SangHyeon-Shin/SAVER/teensy/README_demo.md

# 수동 배치 시연 펌웨어 — 2026-10-23

마네킹·벤치 연구용. 임상 사용, 사람 대상 시험용이 아니다.
`saver_teensy.ino`가 진입점이며 구현은 `src/demo/`에 있다.
Arduino IDE에서는 **이 폴더의 `teensy.ino`를 연다. 폴더 전체를 유지한다.**
보드 Teensy 4.1, USB Type Serial, SparkFun MAX3010x 라이브러리가 필요하다.
`test_saver_proto.cpp`는 Arduino 빌드에서는 제외되고 PC 시험에서만 실행된다.

## 현재 가능한 것과 아직 안 되는 것

- `implemented`: VESC 전류 지령 기반 리니어 위치 PID, NAU7802 보정·힘 취득·힘 상한 정지,
  블로워 2개/압력 취득·간헐 제어, MAX30102 추정치 취득, JSON/직접 명령 공통 인터록,
  음압 확보 뒤 유한 압박을 시작하는 로컬 `BOTH` 통합 시험.
- `tested`: PC 모의 USB/UART/ADC/I²C 시험과 Teensy 컴파일. 실물 통합 시험 아님.
- `planned`/미검증: 실제 정지거리·보호 임계·블로워 운전 시간·전체 연결 동작.
  원점 리미트가 없으므로 **자동 HOME/탐색/압박점 접촉 탐색은 지원하지 않는다.**
- HOME은 `HOME_UNAVAILABLE_NO_VERIFIED_LIMIT`로 거부한다. 모터를 움직이지 않고
  HOMING_DONE/CP_ZERO_SET를 보내던 이전 자리표시자는 제거했다.
- **기존 Jetson UI의 S1→HOME→자동 탐색 전체 시나리오는 이 빌드로 통과하지 않는다.**
  수동 시연 UI/브리지 흐름은 해당 담당자와 별도 합의가 필요하다. `protocol/`, `jetson/`,
  `ui/`는 수정하지 않았다. 수동 시험 준비 뒤 START/PAUSE/RESUME/STOP JSON은 시험 가능하다.

## 먼저 확인 — 압박은 아직 기본 설정으로 구동되지 않는다

`src/demo/src/bench_config.h`의 미확인 보호 설정을 임의로 true/숫자로 채우지 않았다.
센서 읽기·보정·PPG는 가능하지만 `CP PREPARE`/`CP RUN`은 이 검증 전에는 거부한다.
`CP CHECK`에 실패 항목과 최종 구동 거부 이유가 나온다.

필요한 실측/확인:

1. VESC의 독립 명령 timeout 설정과 UART 분리 시 정지 확인.
2. 센서 배선/불량 입력 시험과 실물 조립 상태의 방향·보호 설정 검증.
3. 수동 영점 양쪽의 실제 소프트 경계와 정지 여유. 사용자 보고의 50 mm는 **기구 끝 근처의
   경계**이므로 TARGET 50 mm를 기본으로 넣지 않았다. 목표는 경계·보정 거리보다 작아야 한다.
4. 시작 위치/속도 허용치, 추종 오차, 센서 변화율·노이즈, 프로파일 속도/가속도 한계.
5. 위 검증 뒤 마지막으로 `BENCH_DRIVE_CONFIRMED`. 단순히 구동하려고 일괄 true로 바꾸면 안 된다.

LM 소스의 기본값은 ILIMIT 6 A, INLIMIT 2.8 A였다. 이 값은 실측으로 결정한 새 권장값이 아니다.
메인의 깊이/분당 횟수는 0/미설정으로 시작하며 TARGET을 보내기 전에는 압박하지 않는다.
메인은 PROJECT_STATE의 초회 6 A/정상 감시 12 A와 맞춰, 전류 명령 상한을 초회 6 A로 유지했다.
입력 전류, 모터 전류는 서로 다른 값이다. PSU의 10 A 정격을 모터 전류 한계로 취급하지 않는다.
상단/하단 스위치와 E-stop 보조접점은 사용자 설명대로 미장착이다. 없는데 정상이라고 보고하지 않는다.
이 스위치 생략은 **사람 없는 수동 벤치 치구 범위**에만 해당한다.

## 직접 명령: 시리얼 모니터, 115200, Newline 또는 CRLF

모든 출력은 LF로 끝나는 JSON이다. 직접 명령 결과는 BENCH_LOG의 msg 안에 표시된다.
보정값/동작은 장치가 자동 추정해서 채우지 않는다. `<...>`는 확정한 값을 넣을 자리이며 그대로 입력하지 않는다.

### 1. 센서부터

```text
STREAM OFF
HELP
STATUS
PPG ON
```

`STATUS`에서 힘/압력/PPG/현재 위치의 진단을 볼 수 있다. 주기 요약은 기본 20 Hz이다.
직접 시험에서 스크롤이 빠르면 STREAM OFF로 주기 출력만 끄고 STATUS로 확인한다.
센서/제어/인터록은 계속 작동한다. STREAM ON으로 다시 켜며 REMOTE 전환 시 출력도 복구한다.
손가락 접촉·신호 품질이 확보되기 전 HR/SpO2는 생략하며 임의 숫자로 대체하지 않는다.
SpO2/심박 추정의 임상 정확도를 검증한 것은 아니다. 종료는 `PPG OFF`.

### 2. 압박부 보정·준비

기존 안전한 보정 방법으로 기준 위치와 실제 이동 거리를 잡는다. 보정 명령 자체는 모터를 돌리지 않는다.

```text
CP ZERO
CP CAL <실제로_이동한_양의_거리_mm>
```

CAL 뒤 기준 위치로 복귀하고 멈춘 뒤 진행한다. ZERO는 새 RAM 보정을 시작하고 CAL을 무효화한다.
기존 리니어 EEPROM 보정은 부팅 때 읽으며, 위 명령으로 EEPROM 원본을 덮어쓰지 않는다.
센서/기구 설치가 바뀌면 보존된 값이 있어도 영점·방향·실측 거리를 다시 확인한다.

```text
CP TARE
CP FORCE_CAL <실제로_올린_기준_질량_kg>
```

TARE 완료 로그를 기다린 뒤 기준 질량을 가하고 FORCE_CAL을 보낸다. 완료를 기다리고 질량을 제거한다.
질량은 0 초과 100 kg 이하이며 센서·치구 허용 하중을 넘기지 않는다. 평균 320개의 신규 샘플을 사용한다.
두 측정 구간이 겹치거나 레일/시간 초과면 보정을 인정하지 않는다. 힘은 N으로 환산한다.
보정은 RAM에 있어 재부팅하면 다시 필요하다. USB 단순 재연결은 완료된 센서 보정을 지우지 않는다.
NAU7802 오류 후 재시험은 `CP SENSOR_RETRY` → TARE → FORCE_CAL. 자동 재시작은 없다.

```text
CP TARGET <시험_깊이_mm> <분당_완전_왕복_횟수>
CP FORCELIMIT <확정한_벤치_힘_상한_N>
CP ILIMIT <검토한_모터_명령_전류_상한_A>
CP INLIMIT <검토한_입력_전류_정지_기준_A>
CP CHECK
```

힘 상한은 처음에는 0/미설정이며, 설정 전에는 압박을 거부한다. 입력 허용 상한 600 N은 D-30의
벤치 시험 상한이지 임상 상한이나 모든 치구에 안전한 값이 아니다. 더 낮은 치구 한계를 우선한다.
CHECK가 실제 검증 설정/실시간 상태를 모두 통과했을 때만:

```text
CP PREPARE
CP RUN 3
STOP
```

RUN 3은 3회 완전 왕복이다. RUN만 보내면 1회. 모든 RUN은 사용자 요청의 최대 10분 제한을 받는다.
시작/종료의 위치 오차, 추종·힘·전류·센서·VESC·시간 이상은 정지한다. 기구 끝을 원점/목표로 쓰지 않는다.
PREPARE는 **수동 벤치 기준 확인**이지 자동 HOME/접촉 탐색 완료가 아니다. 설정 변경·STOP 후 다시 필요하다.
`STOP`은 압박 정지 요청이며 **흡착은 유지한다**. VESC 전류 0은 능동 제동/위치 유지 보증이 아니다.
고장은 원인을 제거하고 `CP CLEAR`; 자동으로 RUN을 다시 보내지 않는다.

### 3. 음압부

센서 분압은 사용자가 실제로 설치한 위 4.7 kΩ/아래 10 kΩ 기준이다. 공급전압 이상을 영점 보정으로 숨기지 않는다.
센서 OUT 5 V까지 입력될 경우 이 분압만으로 ADC 3.3 V 초과를 막지 못하므로 전기적 보호를 따로 확인한다.

```text
VAC CONFIG <듀티_pct> <최대_연속_ON_ms> <도달_안정_ms> <해제_압력대역_kPa_양수> <해제_안정_ms>
VAC ARM
VAC RUNBOTH <모터1_pct> <모터2_pct>
VAC OFF
```

운전/해제 시간·대역은 미확정이므로 기본 0이다. 팀이 확인한 값을 넣기 전에는 구동/자동 해제 판정을 막는다.
RUN1/RUN2도 가능하며 수동 듀티 시험도 최대 연속 ON 시간을 적용한다. 시간 만료/압력 무효/ERR는 정지한다.
`VAC CLEAR_ERR`는 원인이 없어지고 ERR가 안정적으로 정상인 뒤에만 해제한다. 고장/시간 제한을 우회하지 않는다.

`VAC ON`은 D-27 정책의 자동 간헐 제어다: 목표 −22.5 kPa에서 정지, −20 kPa보다 약해지면 재기동.
설정한 연속 ON 상한에 도달하면 −20 kPa 이하인 경우 도달 압력을 정지 기준으로 삼고, 미달이면 정지·고장 처리한다.
실제 흡착 도달 판정을 기다린 후에 압박을 준비한다. 체크밸브/블로워 온도·저유량 허용시간은 미검증이다.
`VAC OFF`는 출력 OFF일 뿐 즉시 흡착 해제 보증이 아니다. 압력 대역/시간을 만족해야 mot.vac_released가 true다.
압박 중 VAC 설정/해제를 거부하므로 먼저 STOP한다.

### 4. 음압 + 압박 통합 시험 (`BOTH`, 직접 벤치 명령만)

`implemented`, PC 모의 `tested`; 실물 통합 구동은 미검증이다. Jetson JSON 명령/상태머신은
추가하거나 바꾸지 않았다. `BOTH`는 별도 운용 상태가 아니라 기존 제어기를 순서대로 요청하는
벤치 보조 기능이다. PPG를 자동으로 켜지 않는다.

사용자가 설명한 공급 전류 배분은 **블로워 각각 3 A + VESC 입력 3 A**다. 총 9 A이며,
10 A 전원의 계산상 잔여는 1 A다. 이는 모터 정격이나 총전류 실측/제어를 뜻하지 않는다.
블로워 듀티 약 22에서 각각 약 3 A, VESC 모터 전류 지령 10 A에서 공급 전류 약 0.6 A를
봤다는 사용자 관찰이 있다. **기동·부하 변화 때 최대값, 동시 시험 결과는 아직 미검증**이다.
VESC 모터 측 전류와 입력 전류를 혼동하지 않으며, 이 관찰만으로 메인의 초회 모터 지령
상한 6 A를 10 A로 올리지 않았다. 입력 3 A는 수신값 기반 정지 기준이지 순간 하드웨어 제한이 아니다.

먼저 앞 절의 리니어/로드셀 보정·목표·힘 상한과 구동 보호 검증을 끝내고, 압박 정지/음압 OFF,
압력관 대기 개방 상태에서 시작한다. **대기 개방 −24.60 kPa 오류를 먼저 해결한다.**
설정한 해제 압력대역/시간을 만족해야 시작할 수 있다. 이것은 잘못된 영점으로 흡착 완료를
판정하지 않기 위한 검사이며, 센서 정확도 교정을 대신하지 않는다.

```text
VAC CONFIG 22 <최대_연속_ON_ms> <도달_안정_ms> <해제_압력대역_kPa> <해제_안정_ms>
CP INLIMIT 3
BOTH POWER <블로워1_최대_공급_A> <블로워2_최대_공급_A> <같은_전원의_기타_최대_부하_A>
CP PREPARE
BOTH CHECK
BOTH RUN 3
```

- 듀티 22는 사용자 관찰값일 뿐 **3 A 정전류 설정이 아니다**. 사용할 듀티에서 기동 포함
  전류를 재고 `BOTH POWER`에 상한을 기록한다. 각 블로워 상한은 3 A 이하, 기타 부하 포함
  합계 + 압박 입력 배정 3 A는 10 A **미만**이어야 한다. `other=0`은 같은 전원에 기타 부하가
  실제로 없을 때만 쓴다. 총전류 센서는 현재 사용하지 않으므로 이 입력값을 자동 검증할 수 없다.
  `BOTH POWER 3 3 0`은 이 조건을 실측 확인했을 때만 사용할 수 있는 예다.
- `CP INLIMIT`은 3 A 이하를 허용한다(기본 2.8 A도 이하). `CP ILIMIT`은 **모터 측 지령 한계**로
  별개이며 기존 설정/보호를 유지한다. 강제로 정확히 3 A를 소비하게 하는 기능은 없다.
- POWER는 준비 허가를 취소하므로 **그 뒤 CP PREPARE**한다. VAC 설정/듀티/ARM/ON 변경이나
  USB 재연결 뒤에는 POWER를 다시 기록한다. 기존 보정값을 새로 만들거나 지우지는 않는다.
- `BOTH CHECK`는 준비 안 된 첫 이유를, `BOTH STATUS`는 대기/구동/공급 예산을 보여 준다.
  CHECK가 통과해도 실물 안전 검증을 보증하지 않는다. 기본 구동 잠금은 그대로다.
- RUN은 먼저 블로워 2개를 자동 제어하고, 유효한 압력으로 안정된 흡착이 확인돼야 압박을 시작한다.
  압박 시작 직전에도 같은 인터록을 다시 검사한다. 리니어/로드셀/압력을 계속 읽는다.
  위 예는 **이미 설정한 깊이·분당 횟수로 3회 왕복**이다. RUN 인수는 듀티나 전류가 아니다.
- 흡착 대기는 CONFIG의 최대 연속 ON 시간과 같은 길이를 **총 대기 상한**으로도 적용한다.
  그 안에 안정 도달하지 못하면 블로워 출력을 끄고 압박을 시작하지 않는다. 압박 시작 후에는
  흡착 유지 제어를 병행한다. 요청부터 총 10분 상한 또는 요청 횟수 완료 시 압박을 멈춘다.
  압박 종료/일반 고장 시에는 흡착을 자동 해제하지 않는다.
- `STOP` / `BOTH STOP`은 압박을 멈추고 대기 중 자동 시작도 취소하며 **음압은 유지**한다.
  실제 기구 정지를 확인하고 필요할 때 `VAC OFF`로 별도 해제한다. USB 단절·손상 명령·센서 고장도
  미완료 요청을 취소한다. 재연결/오류 해제 뒤 자동 재시작하지 않는다.
- 음압 단독의 5 A × 2 계획은 전원 10 A 전부이므로 기동/기타 부하 여유가 없다. 듀티를 전류로
  바꾸거나 자동으로 상향하지 않았다. PSU CC 설정, 기동 전압 강하·총전류·VESC 회생은 실측한다.

## Jetson JSON 제어와 직접 제어의 구분

- 기본 v1.1: GET_INFO/GET_STATUS/PING/GET_FAULTS는 seq만 필요하다.
- 그 밖에는 INFO의 boot_id를 bid로, 증가하는 aid를 넣는다. wire 필드 v는 여전히 1이다.
- 동일 요청 재전송은 최초 ACK를 재전송하고 동작을 반복하지 않는다. 거부 ACK도 그대로 보존한다.
- STOP_CPR/PAUSE_CPR/DISARM/DRIVE_STOP은 완전한 JSON 구조·정확한 명령명을 확인한 뒤,
  bid/aid/버전 검사에 앞서 해당 정지 출력을 적용한다. VACUUM_OFF는 이 예외가 아니다.
- INFO에는 실제 구현한 AID/MOT만 광고한다. DRIVE/HEAD_HOLD/CP_ZERO는 광고하지 않는다.
  미합의 고장 코드를 지어내거나 기존 코드 의미를 바꾸지 않는다. 대응 코드가 없는 벤치 고장은
  FAULT 상태와 BENCH_LOG 사유로 보고하고, faults를 빈 배열로 꾸미지 않고 생략한다.
  GET_FAULTS는 합의된 코드의 err와 FAULTS_END를 반환하나 미할당 벤치 고장이 있어 FAULTS capability는 광고하지 않는다.
  원인 제거 후 `CLEAR_FAULT` 또는 원격 `RESET_FAULT`로 해제를 요청한다. 구동은 다시 준비해야 한다.
- 직접 시험이 제어권을 갖고 있으면 JSON 구동 요청을 거부한다. 조회·정지는 항상 처리한다.
- 원격 ARM은 PPG 관측도 시작한다. 직접 시험은 `PPG ON`으로 별도 시작한다. 센서 취득만으로 압박을 시작하지 않는다.

직접 보정/목표 설정/CP PREPARE를 마치고 압박이 정지한 상태에서:

```text
CONTROL REMOTE
```

그 후 Jetson 시험 클라이언트가 GET_INFO로 세션을 확인하고 START_CPR을 보낼 수 있다.
시리얼 모니터와 Jetson 브리지가 같은 포트를 동시에 열면 안 된다. 열고 닫으면 준비/제어권은 취소되므로,
Jetson 시험 클라이언트가 연결된 같은 세션에서 명시적인 벤치 준비를 해야 한다. 기존 UI에 이를 몰래 추가하지 않았다.
원점 리미트 없는 전체 UI 초기화 문제를 성공 이벤트로 숨기지 않는다.

```json
{"v":1,"t":"cmd","seq":1,"cmd":"GET_INFO"}
{"v":1,"t":"cmd","seq":2,"cmd":"GET_STATUS"}
{"v":1,"t":"cmd","seq":3,"cmd":"PING"}
{"v":1,"t":"cmd","seq":4,"cmd":"PAUSE_CPR"}
{"v":1,"t":"cmd","seq":5,"cmd":"STOP_CPR","reason":"USER_STOP"}
```

START_CPR/RESUME_CPR는 모든 인터록을 다시 검사한다. RESUME는 CPR_PAUSED에서만 받는다.
임의의 중간 위치에서 재개하지 않으며, 기존 리니어 제어의 시작 원점/안정 조건을 다시 만족해야 한다.
PAUSE ACK는 수락만 뜻한다. 전류 0 송신이 끝나고 신규 VESC 정지값과 리니어 속도가 안정된 뒤 CPR_PAUSED가 된다.
STOP/FAULT 상태나 ACK만으로 실제 완전 정지가 확인됐다는 음성을 내면 안 된다.
원격 제어에서는 유효 JSON이 2초 동안 없으면 압박을 즉시 정지하고 음압은 유지한다.
미확정 T_comm의 30초 지속은 하지 않는다. 신규 START/RESUME는 최대 10분의 유한 시험이다.

작업 트리의 구형 v1.0 Jetson을 사용할 때만 정지 중 명시적으로 `CONTROL REMOTE_V1`을 선택한다.
seq만 있는 구형 요청을 받고 최근 8건의 ACK를 저장한다. INFO도 proto 1.0/caps 빈 배열로 응답한다.
**aid가 없다는 이유로 자동 강등하지 않는다.** v1.1 연결은 `CONTROL REMOTE`를 사용한다.
구형 형식에는 bid/aid를 통한 과거 세션 배제가 없다. 연결이 끊기면 과거 동작 요청을 재송신하지 않는다.

## 전원/정지의 제약

USB 재연결은 RAM 초기화가 아니지만 압박 구동 허가/미완료 명령/준비 상태는 취소한다.
리니어 저장 레코드 4096..4135를 보존하고 별도 4160..4175에 이중 기록으로 boot_id를 쓴다.
재부팅/전원 차단은 RAM 하중 보정/설정/준비를 지운다. boot_id 기록에 실패하면 ARM/구동을 허용하지 않는다.
일반 DISARM/압박 FAULT/통신 단절은 흡착을 임의로 해제하지 않는다. 압력 센서/블로워 자체가 고장 나면
음압 출력을 정지하고 압박도 멈춘다. 물리 E-stop의 전력 차단 범위를 소프트웨어로 보증하지 않는다.

**Teensy를 Jetson USB로만 급전하면 USB 전원 차단 때 프로그램도 멈춘다.** 그 뒤 STOP을 보낼 수 없다.
독립 VESC timeout, 블로워 EN/VSP 외부 풀다운, 물리 전원 차단이 필요하다.
Teensy의 USB/3.3 V에서 모터를 급전하지 않는다. 모터 측 +5 V 출력도 연결하지 않는다.
센서 소비 전류/Jetson 전원 여유, 역급전, 실제 정지는 별도 실측한다.

## 검증 명령

```powershell
powershell -NoProfile -ExecutionPolicy Bypass -File teensy/tests/demo/check_main.ps1
powershell -NoProfile -ExecutionPolicy Bypass -File teensy/tests/check_pinmap.ps1
arduino-cli compile --fqbn teensy:avr:teensy41 --warnings all --build-path <임시_빌드_경로> teensy
```

PC 표준 시험: `g++ -std=c++11 -Wall -o <임시_실행파일> teensy/test_saver_proto.cpp` 뒤 실행한다.
새 합성 fixture는 PC 시험 전용이며 Arduino가 읽지 않는다. 실기 업로드/통전 시험은 자동 실행하지 않는다.

### 이번 작업의 검증 기록

- `tested`(PC 모의): 기본 설정 207개 + 합성 치구 317개, 합계 524개 통과.
  구동 잠금, 실제 메인 명령 경로, 부호/전류 한계, 중복·거부 ACK, 잘린 줄, USB 재연결,
  압력/힘/센서/VESC/UART 고장, 간헐 음압·시간 상한, 부팅 기록 실패 우회 방지를 검사했다.
  통합 시험의 음압 안정 선행/왕복 횟수/입력 전류 3 A 초과 정지/유한 종료/총 시간 상한,
  대기 중 취소·USB·VESC·로드셀·압력 고장, 전류 예산과 듀티 변경 시 재확인도 검사했다.
- `tested`(PC 모의): 출력 JSON 1190줄의 구문/길이와 tel/mot의 tn·ms·boot_id 짝을 검사했다.
- `tested`(PC): 기존 test_saver_proto.cpp 26/26, 핀맵 컴파일 시 단언 19개와 소스 가드 통과.
- `tested`(빌드): 실제 teensy 폴더를 Teensy 4.1로 컴파일 성공. 프로젝트 코드 경고 없음;
  SparkFun 외부 라이브러리의 기존 경고 4개는 남아 있다.
- 포맷, git diff 공백 검사, tools/consistency_audit.py 통과. protocol/jetson/ui 변경 없음.
- 하드웨어 `planned`/미검증: 업로드, 실전압/실전류, 실제 이동·정지거리, 실물 안전 인터록,
  열/장시간 운전, USB 전원 상실과 역급전, 전체 UI 연결. 위 PC 결과로 이를 통과했다고 주장하지 않는다.
