SangHyeon-Shin/SAVER/docs/DECISIONS.md

# 기술 결정 기록

**"왜 이렇게 되어 있는가"에 대한 답입니다.**
같은 논의를 반복하지 않기 위해, 그리고 최종보고서를 쓸 때 근거를 다시 찾지 않기 위해
남깁니다. 결정을 뒤집을 때는 이 문서를 먼저 고치세요.

---

## 아키텍처

### D-01 · 상태머신의 주인은 Jetson 브리지다

**결정**: 운용 상태머신(S1~S13)은 Python 브리지가 소유한다.
UI 는 `intent` 를 보내고 받은 `state` 를 그리기만 한다.

**이유**: 레이더·카메라·PPG 판단 입력이 전부 Python 에 도착하는데,
상태의 주인이 브라우저에 있으면 판단과 화면이 어긋난다.
UI 를 새로고침해도 장치 상태가 바뀌면 안 된다는 요구사항과도 맞는다.

**예외**: 브리지 미연결 시 UI 가 로컬 전이로 대체한다. **오프라인 시연 전용**이며,
연결되면 즉시 브리지 판단으로 넘어간다.

### D-02 · 상태머신 정의는 파일 하나뿐이다

**결정**: `protocol/state_machine_v2.json` 이 유일한 기준.
Python 은 직접 읽고, UI 는 빌드 전에 자동 복사(`ui/scripts/sync-protocol.mjs`)한다.

**이유**: 처음에는 UI 와 Python 이 각자 전이표를 갖고 있었다.
한쪽만 고치면 조용히 어긋나고, 통합 시점에야 발견된다.

### D-03 · Jetson 은 실시간 제어를 하지 않는다

**결정**: 100~500 Hz 제어 루프는 Teensy 전담. Jetson 은 목표값만 보낸다.

**이유**: Linux 스케줄링, USB 지연, Python GC, UI 부하 때문에 제어 주기가 흔들린다.
`S2_데이터_수집처리_정의서` 에 기구 제어 데이터가 100~500 Hz 로 정의돼 있다.

**금지되는 구조**
```
Jetson 이 깊이를 읽음 → Python 에서 PID 계산 → 매 주기 Teensy 에 PWM 명령
```

### D-04 · 장치가 준비되지 않으면 화면이 넘어가지 않는다

**결정**: `state_machine_v2.json` 의 `requires_mcu` 로 전이 선행조건을 검사한다.

**이유**: 종단간 시험에서 실제로 발생했다. 흡착이 끝나기 전에 사용자가
[재확인]을 연타하니 UI 만 앞서 나갔다. 레이더·카메라가 붙으면 더 심해진다.

거부되면 UI 에 `{"reason":"device_not_ready","mcu":"HOMED"}` 가 전달되고
"장치 준비 중" 안내가 뜬다.

### D-05 · 압박점 확정은 장치가 주도한다

**결정**: `SCAN_RESULT` 를 받는 즉시 브리지가 `SET_CP_POINT` 를 보낸다.
사용자의 [확인] 버튼과 무관하다.

**이유**: 사용자가 버튼을 늦게 누르면 장치가 `CPR_READY` 에 못 올라가
다음 상태 진입이 막힌다. 화면 진행과 장치 준비를 분리해야 한다.

### D-06 · 통신은 JSON Lines, 라이브러리는 쓰지 않는다

**결정**: 한 줄에 JSON 하나. Teensy 측은 `saver_proto.h` 자체 파서.

**이유**: 시리얼 모니터로 눈으로 읽으며 디버깅할 수 있다.
프로토콜이 1단계 평면 구조라 ArduinoJson 이 필요 없고, 라이브러리 버전 문제도 없다.
PC 에서 `g++` 로 단위시험도 된다.
데이터량이 실제로 문제가 되면 그때 COBS/CBOR/바이너리로 바꾼다.

### D-07 · 측정 불가 필드는 0 이 아니라 생략한다

**결정**: 값이 없으면 필드를 통째로 뺀다.

**이유**: `0` 을 보내면 Jetson 이 "정상적으로 0" 으로 오해한다.
PPG 신호 품질이 나쁠 때 심박 0 과 미측정은 완전히 다른 의미다.

### D-08 · 심각도 3 오류는 정지가 먼저, 보고가 나중

**결정**: Teensy 는 모터를 끈 뒤에 `err` 메시지를 보낸다.

**이유**: 보고를 먼저 하면 그 사이 시리얼이 막혔을 때 모터가 계속 돈다.

### D-09 · 소프트웨어 정지는 물리 E-stop 을 대체하지 않는다

**결정**: E-stop 은 USB 와 무관한 하드웨어 회로가 모터 출력을 끊는다.
Teensy 는 그 사실을 보고만 한다.

**이유**: Jetson 이 죽어도, 시리얼이 끊겨도, 펌웨어가 멈춰도 정지해야 한다.

### D-10 · 제어 보드는 Teensy 4.1 (2026-08-03)

**결정**: Teensy 4.1. PCB 미발주.

**이유**: 이력의 회로도·펌웨어는 ESP32-S3 기준이었으나 발주 전이라 변경 비용이 없다.
Teensy 4.1 은 하드웨어 FPU 가 있어 제어 루프에 유리하고, 네이티브 USB 라
UART 브리지 지연이 없다.

**영향**: 핀 전면 재배정, `analogReadResolution(12)` 필요, PCB 재작성.
자세한 내용은 `teensy/reference/README.md` §2.

---

## 기구·전기

### D-20 · 감속비 1.5 (2.0 아님)

**결정**: 타이밍 벨트 1.5:1.

**이유**: 2.0 이면 필요 회전수가 저전압 구간에서 부족했다.
1.5 로 낮추면 2,592 RPM 이면 되고 RPM 부족이 해소된다.
모터는 BL60120-2430 (Ke = 4.45 V/kRPM).

### D-21 · 볼스크류 후보는 1사이클 전체 프로파일로 검증한다

**결정**: 피크값 합산 방식은 쓰지 않는다.

**이유**: 피크 합산은 힘을 약 2.5배 과대평가한다. 후보가 잘못 탈락한다.

### D-22 · PETG-HF 는 준취성으로 다룬다

**결정**: FEA 에서 인장강도 하한값을 항복강도 대용으로 쓰고 안전계수를 추가한다.

**이유**: 명확한 항복점이 없다. **Z 방향 강도가 32% 감소**하므로
반복 하중을 받는 부품은 적층 방향을 반드시 고려해야 한다.

### D-23 · 설계 목표 음압은 −22.5 kPa 이며 −30 kPa 는 도달 불가 (2026-09-08 근거 보강)

**결정**: 목표 −22.5 ±2.5 kPa (펌웨어, 2026-08-03 확정). 검증 합격선은 허용 하한 −20 kPa.

**이유**: 음압 블로워 BL6561-P(24 V) 팬 커브의 dead-head 정압이 약 27.3 kPa 라
−30 kPa 는 이 블로워로 물리적으로 도달할 수 없다. CFD 누설 해석
(`SAVER-docs/cfd/SAVER_CFD_results_final.csv`)에서 바닥 슬릿 갭 0.05~0.30 mm 의
운전점은 −27.0~−17.8 kPa 이고, −22.5 kPa 는 갭 약 0.19 mm 까지, 허용대역
−20~−25 kPa 는 갭 약 0.12~0.25 mm 에 해당한다. 초기 문서(중간보고서, ESP32 코드)의
−30 kPa 는 블로워 선정 전 목표였다.

### D-24 · "유지력 상한 290 N" 폐기 → 명목 유지력 3600 N (−20 kPa) (2026-09-08)

**결정**: 유지력은 F = ΔP·A_eff 로 표기한다. 1:1 명목 면적 0.18 m² 기준 −20 kPa 에서
3600 N, −22.5 kPa 에서 4050 N. A_eff 는 1:1 CAD 챔버 내측 치수로 확정한다(서정준).

**이유**: 290 N 은 dead-head 27.3 kPa 에 CFD 모델의 패드 면적을 곱한 값이다. CFD 그림
스크립트의 면적 상수(π·0.058² ≈ 106 cm², 반지름 58 mm 축대칭 원형 모델)로 2026-09-10 확인.
1:2 축척 추정이라는 초기 기록은 잘못이었다. 이 면적은 실제 300×300 mm 패드가 아니므로
유지력 상한으로 쓰지 않는다. 단, 같은 이유로 CFD 운전점(Table 6)도 모델 형상 기준이며
실제 패드(누설 둘레 6.6배)에서는 더 낮을 수 있다 → 재해석 항목.

**영향**: requirements R2, evidence C3, `report/02_design.qmd`, `tools/consistency_audit.py`
CHECKS 갱신. 보고서에는 명목 유지력을 `simulated` 로, 실측은 T1 이후 `tested` 로.

### D-25 · 시제품 축척은 1:1 (2026-09-08)

**결정**: 1:2 축척을 폐기하고 1:1 로 출력한다.

**이유**: 길이를 1/2 로 줄이면 면적·하중이 1/4 이 되어 T1 결과를 실기 값으로 환산할 수
없다. 보고서 v9 2.4.1·2.8.1 의 축척 서술은 삭제한다. FEA 모델 축척도 1:1 인지 확인한다.

### D-26 · 요구 최소 음압 산정 기준 (2026-09-08)

**결정**: 요구 최소 음압 = 최대 압박력 555.1 N × 안전율 2 / 명목 면적 0.18 m² ≈ −6.2 kPa.

**이유**: 이전 −5.6 kPa 는 500 N 기준이었고, 확정 최대 압박력 555.1 N 과 정합시킨다.
설계 목표 −22.5 kPa 는 요구의 약 3.6배로, 누설·표면 상태 여유다.

### D-27 · 블로워 최소 연속 운전 유량과 간헐 운전 (확인 조건부, 2026-09-08)

**결정(안)**: BL6561-P 의 최소 연속 운전 유량 400 L/min(제조사 자료 확인 전, 가정)을
밑도는 운전점에서는 연속 dead-head 운전을 하지 않는다. 블로워는 p_g 가 목표 −22.5 kPa
에 이르면 정지하고 허용 하한 −20 kPa 보다 약해지면 재기동한다. 목표에 도달하지 못하는
조건(예: 24 V·갭 0.20 mm 의 −21.8 kPa, 공칭 22.2 V)에서는 정지 조건이 성립하지 않으므로
도달 시간 상한(설정값) 안에 목표 미달이면 (a) p_g ≤ −20 kPa 이면 도달 압력을 유지 기준으로
삼아 대역을 [도달 압력, −20 kPa] 로 두고 (b) −20 kPa 미달이면 2-VU-004 로 보고·정지한다
(2026-09-10 보완). T1 은 정전압 24 V 조건으로 한정한다.

**이유**: 최소 연속 유량 400 L/min 과 dead-head(유량 0)는 동시에 성립할 수 없다.
400 L/min 에서 팬 커브 정압은 약 19 kPa 로 목표 −22.5 kPa 에 못 미친다.

**확인**: 데이터시트 원문(한건민), 제어 구현(한건민). 확인 전에는 `assumed`.

### D-28 · 시험 합격 기준의 출처 (2026-09-08)

T1 은 −20 kPa (허용 하한) 도달·유지. T2 는 깊이 ±5 mm, 속도 100~120 회/min
(W11 마네킹 시험 프로토콜·지침). 설계 목표(±2 mm, 110 ±2 회/min)는 합격 기준과
분리해 표기한다. 음압 도달 시간은 합격 기준이 아니며 실측 후 결정한다.

### D-29 · 압박 운동 프로파일: 사인파를 설계 기준으로, 삼각파는 제어 해석·힘 상한 산정에 (2026-09-08)

**결정**: 구동계 선정과 회전수 여유 검토는 사인파 궤적(스트로크 50 mm, 110 회/min → 최대 속도
0.288 m/s, 2,592 rpm)을 기준으로 한다. Simulink 제어 해석은 삼각파 목표(0.183 m/s, 1,650 rpm)로
수행하며, 최대 압박력 555.1 N 은 삼각파에서 강성항·점성항 최대값을 더한 보수적 상한이다
(사인파 위상 고려 시 약 515 N).

**이유**: v10 은 2.6.1(삼각파 속도), 2.6.2(사인파 회전수), 2.6.3(삼각파 목표)을 같은 조건처럼
연결하고 있었다. v4.2 종합해석도 사인파 궤적이므로 선정 기준을 사인파로 통일하고, 다른
프로파일의 값은 그 조건을 명시해 병기한다. 펌웨어가 실제로 지령할 프로파일은 구현 시 확정.

### D-30 · 벤치 시험 설정값은 임상 적용값과 분리한다 (2026-09-08)

**결정**: 벤치 시험 설정 깊이 50 mm(지침 약 5 cm, 마네킹 시험 프로토콜 50~60 mm 범위 내),
시험 힘 상한 600 N(구조 설계 하중). 시험체·구동부의 허용 범위에서 추종·제한 동작을 평가하기
위한 값이며, 환자에게 적절한 깊이·힘을 확정한 것이 아니다. 임상 적용값(`target_depth_mm`,
`force_max_N`)은 여전히 한성윤 확인 대상이다.

**이유**: 모든 시험 설정을 의학 검토 대기로 두면 핵심 공학 시험(T2)까지 지연된다.

---

### D-32 · 자이로 UART 확보와 로드셀 독립 I²C (2026-10-02)

**결정**: 사용자 선택으로 NAU7802를 Wire1(SDA 17 / SCL 16)에 분리하고,
주행 모터 1 엔코더 A/B를 11/12로 옮긴다. MAX30102는 Wire(18/19)를 유지한다.
WT901C-TTL은 Serial8(RX 34 / TX 35)에 예약하며 음압 모터 2 RUN/EN은 32/37로 옮긴다.
PPG 시험의 음압 2 EN 보호 핀과 음압+압력 시험의 로컬 핀 정의도 함께 변경한다.

**확인**: 사용자에 따르면 압박 모터 Hall은 VESC에만 연결하고 Teensy에는 RX/TX만 연결한다.
39번은 미연결 예비로 유지하며 VESC Hall을 분기하지 않는다. A9/23도 미연결 예비다.

**이유·제약**: I²C 주소가 다른 센서의 버스 공유는 가능하지만 사용자는 버스 분리를 선택했다.
Wire1의 기본 16/17과 엔코더 중복을 해소한다. 11/12를 엔코더에 쓰므로 기본 외부 SPI는
예약하지 않는다. 내장 microSD는 SDIO로 이와 별개다. 음압 1 PWM/상태 핀은 이동하지 않는다.

**수준**: 핀 배정과 시험 코드 버스 변경만 반영한다. 자이로 드라이버·메인 NAU7802 취득은
`planned`이며 UART baud, 전압/풀업, 재배선, 동시 취득과 고장 복구는 실물 미검증이다.
버스 분리는 공통 MCU/전원까지 독립시킨다는 뜻이 아니다. 프로토콜·의학적 임계값은 바꾸지 않는다.

---

## 보고서·논문

### D-30 · ILCOR 인용은 이렇게 구분한다

ILCOR 은 기계식 CPR 의 **일상적(routine) 사용**을 권고하지 않는다.
그 이유는 **생존율 개선이 입증되지 않아서**이지, 장치에 문제가 있어서가 아니다.

SAVER 는 ILCOR 이 인정하는 **"특정 상황(specific circumstances)" 예외**를 겨냥한다.
구급대 도착 전, 다수 사상자, 일반인 구조자 상황이다.

**보고서에서 이 둘을 반드시 구분해서 쓴다.** 뭉뚱그리면 심사에서 "권고에 반하는
장치"로 읽힌다.

### D-31 · 고쳐야 할 보고서 오류

발견됐지만 아직 반영되지 않은 것들입니다. 최종보고서 작성 전에 처리하세요.

| 항목 | 문제 |
|---|---|
| EAPD 계수 | 정확한 값은 **0.436** 인데 **0.467** 로 적힌 곳이 4군데. v9 2.5.3 은 0.436 반영됨 — 나머지 절 집필 시 재확인 |
| 음압 도달시간 | 0D 모델 3 s vs Simulink 9 s — 팬 커브 기준 배기 자체는 1 s 미만이므로 차이는 모터 기동·제어 응답. **T1 실측으로 대체**, 보고서에는 두 예측을 `simulated` 로 병기 |
| 볼스크류 힘 공식 | 차원이 맞지 않음 |
| 배터리 평균 전류 | 퓨즈 60 A 기재 vs 시스템 분석 7.9 A — **불일치** |

---

## 열려 있는 문제

`protocol/teensy_usb_protocol_v1.md` §11 이 정식 목록입니다. 요약하면:

| 항목 | 담당 |
|---|---|
| 목표 압박 깊이·속도 (가이드라인 근거) · 시험 설정 깊이 | 한성윤 |
| 환자 힘 상한 `force_max_N` (구조 설계 하중 600 N 과 별개) | 한성윤 |
| 통신 두절 시 압박 지속 시간 `T_comm` (펌웨어 30 s 플레이스홀더 활성 상태) | 한성윤 |
| ESTOP 시 음압 유지 여부 | 한성윤 |
| ~~과전류 임계~~ → 12.0 A / 초회 6.0 A 확정 (2026-08-03) | 완료 |
| ~~목표 음압~~ → −22.5 ±2.5 kPa 확정, 근거 D-23 (2026-09-08) | 완료 |
| 유효 흡착 면적 `A_eff` (1:1 CAD) | 서정준 |
| 탐색 이송 방식(장치 주행 vs 헤드 이동축)과 상태머신 탐색/고정 순서 | 신상현 + 한건민 + 한성윤 |
| 전압별 블로워 팬 커브 · 승압 여부 (24 V 커브 vs 6S 22.2 V) | 한건민 + 서정준 |
| 흡기 경로 역류 방지 밸브 · 허용 저유량 운전 시간 | 한건민 + 서정준 |
| PCB 회로도 4S 입력 vs 6S 주전원 정합 | 한건민 |
| FEA 탄성계수 가정(500 MPa) 근거 또는 재해석 | 서정준 |
| 블로워 최소 연속 유량 원문 · 간헐 운전 구현 (D-27) | 한건민 + 서정준 |
| PETG-HF 강도 수치 (D-22 32 % vs 30/19 MPa) | 서정준 |
| 압박 모터 드라이버 (VESC vs VSP/EN) | 한건민 |
| 구동계(바퀴) 명령 필요 여부 | 신상현 + 한건민 |
| 냉각팬 제어 주체 | 한건민 |
| PCB 회로도 Teensy 4.1 기준 재작성 | 한건민 |

**추측으로 채우지 않습니다.** 값이 비어 있으면 해당 기능이 동작하지 않도록
막아 두었고, 그게 정상 동작입니다.
