SangHyeon-Shin/SAVER/docs/PROJECT_STATE.md

# SAVER 현재 상태

최종 갱신: 2026-09-08 · 갱신 책임: 신상현(PM)

> **이 파일이 "지금 무엇이 사실인가"의 단일 출처다.**
> 작업을 시작하는 모든 사람과 모든 AI 도구는 이 파일을 먼저 읽는다.
> 오래된 문서의 확정 표현보다 이 파일과 `docs/DECISIONS.md`가 우선한다.

---

## 1. 마감

| 일자 | 항목 | 담당 |
|---|---|---|
| 2026-09-07 | Teensy 4.1 2호기 최초 전원 인가 — **3.3 V 호환 확인 선행 필수** | 한건민 |
| 2026-09-08 | CFD 누설 해석 완료 · Fusion 압박부 설계 수정 · 전원부 설계 수정 | 신상현 |
| 2026-09-09 | NAU7802 수령 → T3 강성 매핑 예비 측정 | 서정준 |
| 2026-09-09 | 산소포화도·호흡센서 커버 3D 출력 · 젯슨 SW 구현 · 최종보고서 초안 완성 | 신상현 |
| 2026-09-09 | 시험 설정 깊이 · 환자 힘 상한 · `T_comm` 회신 (§3) | 한성윤 |
| 2026-09-10 | 중앙대 메이커스페이스: Jetson–Teensy 4.1 통신 · 실데이터 송수신 확인 | 전원 |
| 2026-09-11 09:00 | 지도교수 최종보고서 1차 대면 피드백 | 신상현 |
| 2026-09-13 21:00 | 지도교수 2차 피드백 발송 | 신상현 |
| **2026-09-13 23:59 PT** | **Claude Code 주간 한도 +50% 프로모션 종료** — 이전에 부하 큰 작업 배치 | 신상현 |
| 2026-09-15 12:00 | 지도교수 피드백 수령 → 반영 | 신상현 |
| **2026-09-16 24:00** | **KSME 최종보고서 제출 (hwp)** | 한성윤 |
| 2026-09-29 | 본선 선정 발표 | — |
| 2026-10-24 | 본선 발표·전시, T4 구동부 시험 시연 | 전원 |

## 2. 확정값 (변경 시 `docs/DECISIONS.md`에 기록 필수)

| 항목 | 값 | 출처 |
|---|---|---|
| 시제품 축척 | **1:1** (2026-09-08, 1:2 폐기) | 설계 확정, D-25 |
| `VAC_TARGET_KPA` | −22.5 | 펌웨어 확정, 근거 D-23 |
| `VAC_TOL_KPA` | ±2.5 | 펌웨어 확정 |
| `VAC_MIN_START_KPA` / `VAC_ABORT_KPA` | −15.0 / −10.0 | 펌웨어 확정 |
| 음압 블로워 | BL6561-P, 24 V. dead-head 정압 ≈ 27.3 kPa, 최소 연속 운전 유량 400 L/min | 팬 커브 (데이터시트 원문 확인 전 `assumed`, D-27) |
| 흡착 패드 | 300×300 mm ×2, 챔버 높이 20 mm, **명목 면적 0.18 m²** | 설계서. 유효 면적은 §3 |
| 요구 최소 음압 | −6.2 kPa (555.1 N × 안전율 2 / 명목 0.18 m²) — **A_eff 확정 전 예비값** | 계산, D-26 |
| 명목 유지력 | 3600 N (−20 kPa × 0.18 m²), 4050 N (−22.5 kPa) | 계산. **290 N 폐기 (D-24)** |
| CFD 누설 운전점 (8셀 CFD, 24 V 팬 커브, **축대칭 원형 패드 모델 r≈58 mm 기준**) | 바닥 갭 0.05 / 0.10 / 0.15 / 0.20 / 0.30 mm → −27.0 / −26.2 / −23.7 / −21.8 / −17.6 kPa (24셀 보정 시 차이 ≤ 0.2 kPa). 실제 300×300 패드는 둘레비 6.6 → 더 낮을 수 있음 | `cfd/SAVER_CFD_results_final.csv` + 팬 커브, `simulated` |
| `I_LIMIT_A` | 12.0 (초회 구동 6.0) | 펌웨어 확정 |
| `TEMP_STOP_C` / `TEMP_FAN_ON_C` | 70.0 / 40.0 | 펌웨어 확정 |
| BPM | 110 고정 | 설계 확정 |
| 감속비 | 1.5 | 설계 확정, D-20 |
| 볼스크류 리드 | 10 mm | 설계 확정 |
| 모터 | BL60120-2430 (Ke 4.45 V/kRPM, T_peak 2.85 N·m, I_rated 16 A) | 데이터시트 |
| 최대 압박력 (계산) | 555.1 N — 삼각파 프로파일의 보수적 상한 (강성 10 kN/m × 50 mm + 점성 300 N·s/m × 0.183 m/s). 사인파 위상 고려 시 약 515 N | W9 알고리즘 설계서 p.6 계산식, `simulated` |
| 구조 설계 하중 | 600 N (FEA 케이스 D) | 해석. 환자 힘 상한 `force_max_N` 과는 별개 (§3) |
| 압박 운동 프로파일 | 설계 기준 **사인파** (최대 속도 0.288 m/s, 2592 rpm). 제어 해석은 삼각파 (0.183 m/s, 1650 rpm) | D-29 |
| 벤치 시험 설정값 | 깊이 **50 mm**, 힘 상한 **600 N** — 시험체·구동부 허용 범위의 추종·제한 평가용. **임상 적용값 아님** | D-30 |
| 주전원 | 6S Li-Po 공칭 22.2 V (19.8~25.2 V), 4,200 mAh ×2 병렬. 압박 모터·블로워 직결, 구동 모터 12 V, 5 V 벅 2계통 | 중간보고서 전원 분배 설계 |
| 하중셀 | 100 kgf급 양방향 | 555.1 N·600 N 요구. 이전 300 N 팬케이크형 대체 |
| ADC | NAU7802 (320 SPS, 3.3 V native, I2C) | HX711(80 SPS) 대체 |

## 3. 미확정 — 임의로 채우지 말 것

| 항목 | 담당 | 상태 |
|---|---|---|
| `target_depth_mm` | 한성윤 | 의학적 근거 대기. **T2 실시용 시험 설정값(지침 5~6 cm 범위 내)만이라도 09-09 회신** |
| `force_max_N` (환자 힘 상한) | 한성윤 | 구조 설계 하중 600 N 과 별개 |
| `T_comm` 지속시간 | 한성윤 | 펌웨어에 30 s 플레이스홀더가 활성 상태 → 0/비활성 여부 |
| 유효 흡착 면적 `A_eff` | 서정준 | 1:1 CAD 챔버 내측 치수. 확정 전에는 명목 0.18 m² |
| 탐색 이송 방식 (장치 주행 vs 압박 헤드 이동축) · 상태머신 탐색/고정 순서 | 신상현 + 한건민 + 한성윤 | 중간보고서 설계는 장치 주행 탐색 → 고정. 현재 상태머신은 고정(S5) → 탐색. 보고서 시험은 수동 위치 이송 |
| 전압별 블로워 팬 커브 · 승압 여부 | 한건민 + 서정준 | 팬 커브는 24 V, 주전원 공칭 22.2 V. 회전수∝전압 가정 시 dead-head 약 23.4 kPa(22.2 V)·18.6 kPa(19.8 V) |
| 흡기 경로 역류 방지(체크밸브) · 허용 저유량 운전 시간 · 재기동 주기 | 한건민 + 서정준 | 간헐 운전(D-27)의 구현 조건 |
| PCB 회로도 4S 입력 vs 6S 주전원 정합 | 한건민 | `hardware_mapping.md` §2 |
| FEA 탄성계수 E = 500 MPa 가정 근거 (제조사 자료 1,540~1,810 MPa) | 서정준 | 변위 약 3배 과대평가 가능. 재해석 |
| CFD 모델 형상(축대칭 원형 r≈58 mm, 106 cm²) 확인 · 실제 패드 형상 재해석 | 신상현 | 옛 290 N = 27.3 kPa × 106 cm². 실제 패드 운전점은 Table 6 보다 낮을 수 있음 (D-24 정정) |
| 압력 센서 실장 모델 (설계: 게이지 −100~0 kPa / 펌웨어 변환식: 절대압 2.5~700 kPa) · 변환식·교정식 통일 | 한건민 | T1 은 기준 게이지 압력계 병행 측정 |
| 음압 유지 논리의 도달 시간 상한 · 블로워 연속 운전 허용 시간 | 한건민 | D-27 정지 조건 미도달 시 폴백 규칙 |
| 힘 상한 시험 치구 (k ≥ 12 N/mm 또는 강체 정지구 + 1 kN 기준 로드셀) · 운용 상한 | 서정준 + 한건민 | 제어 개입값 600 N 과 구조 설계 하중 600 N 사이 여유는 초과 하중 실측 후 결정 |
| 블로워 최소 연속 유량 400 L/min 원문 · 간헐 운전 정책 | 한건민 + 서정준 | D-27 확인 조건 |
| PETG-HF 강도 (X-Y 30 / Z 19 MPa vs D-22 "32 % 감소") | 서정준 | 데이터시트 재확인 |
| 압박 모터 드라이버 (VESC vs VSP/EN 드라이버) | 한건민 | 보고서 3.1.3 과 `teensy/pinmap.h` 불일치 |
| 진공·주행 모터 명령 프로토콜 추가 | 신상현 + 한건민 | 미착수 |
| Teensy 4.1용 PCB 회로도 재작도 | 한건민 | 미착수 |

## 4. 검증 상태

| 시험 | 합격 기준 | 상태 |
|---|---|---|
| T1 진공 고정 | p_g ≤ −20 kPa 도달 · 60 s 유지, **정전압 24 V 조건 한정** (6S 전압 범위 미검증). 도달 시간은 기록만 (이상화 1 s 미만 / 설계 목표 3 s / Simulink 9 s), D-28 | **1:1 패드 출력 완료 후** |
| T2 압박 심도·속도 | 깊이 ±5 mm, 속도 100~120 회/min (W11 프로토콜·지침). 설계 목표 ±2 mm, 110 ±2 는 별도 표기 | 시험 설정 깊이 회신 후 |
| T3 강성 매핑 | 스프링 팬텀 4조건 판별 | NAU7802 09-09 이후 |
| T4 바퀴 안전핀 상태 전환 (모듈 시험, **보고서 범위**) | 안전핀 제거·재장착에 따른 바퀴 접지↔패드 접지 전환 10회 반복 | 1:1 출력 후 |
| 전체 이동 시스템 통합 시연 (주행 탐색 + 고정) | — | **10-24** |
| 통신 실데이터 | Jetson–Teensy 4.1 실기 송수신 | 09-10 메이커스페이스 |
| 스프링 팬텀 4조건 (10 / 7.5 / 5 / 2.5 N/mm) | 마네킹 대체, ground truth 확보 | 준비 |

SW: Jetson Nano 실기 검증 완료, 자동화 시험 40/40 통과.

## 5. 주장 수준 표기 규칙

보고서·발표·커밋 메시지에서 아래 5단계를 반드시 구별한다. `docs/evidence.csv`의 `level` 열과 같다.

| 수준 | 의미 |
|---|---|
| `implemented` | 코드/하드웨어에 구현되어 동작 확인됨 |
| `tested` | 시험으로 정량 검증됨. 시험 ID 필수 |
| `simulated` | 해석·시뮬레이션 예측. 실측 아님 |
| `assumed` | 문헌·가정. 본 과제에서 검증하지 않음 |
| `planned` | 미구현. 보고서에서 완료로 서술 금지 |

## 6. 열려 있는 리스크

- 최종보고서 v12 (2026-09-08): 본문 작성 완료, T1~T4 실측 미수행. 이월 항목은 `report/_archive/최종보고서_v10_변경요약.md`
- **블로워 팬 커브(24 V)와 주전원(공칭 22.2 V) 불일치** → 저전압에서 −22.5 kPa 미달 가능. 전압별 커브 또는 승압 결정 필요 (§3)
- `docs/specs/` 파일 확장자 불일치 → `tools/fix_extensions.py`
- 과거 보고서에서 EAPD 계수 오류가 4개소로 전파된 이력 → 제출 전 `tools/consistency_audit.py` 필수 실행. **`.docx` 는 검사하지 않으므로 텍스트로 추출해 검사할 것**
