SangHyeon-Shin/SAVER/docs/specs/S2_요구사항_정의서_자율응급처치시스템.xlsx

Sheet: 요구사항정의서
요구사항ID | 요구사항명 | 기능ID | 기능명 | 세부사항 | 예외사항
A01 | 환자 상태 진단 | A01_B01 | 비접촉 호흡-심박 스캔 | 레이더로 흉부 미세 변위를 스캔하여 호흡-심박 신호를 추정한다. 신호 부재 시 '심정지 의심'으로 1차 판단한다. | 기기 진동-주변 움직임으로 오탐 가능. CPR 구동 중에는 센싱을 일시 차단하고 정지 구간에서만 재측정한다.
 |  | A01_B02 | PPG 기반 맥박-산소포화도 측정 | 구조자가 손가락에 착용시키면 심박수-산소포화도(SpO2)를 측정하여 2차 확정에 사용한다. | 손가락 착용 불가(절단-말초순환 저하) 시 신뢰도 저하. 다른 부위 센서 또는 수동 확인 절차로 전환.
 |  | A01_B03 | ECG 측정-AED 필요 알림 | AED 필요가 의심되면 LCD-통신으로 주변 AED 보유자 또는 시설 관리자 호출을 보조한다. | 전극 접촉 불량-노이즈 시 판독 제한. AED가 이미 리듬 판독 기능을 포함하므로 본 기능은 선별-알림 중심으로 운용한다.
 |  | A01_B04 | ROSC 신호 감지 | CPR 수행 중 주기적으로 압박을 잠시 중단하고 PPG-레이더 신호를 재측정하여 자발순환회복(ROSC) 여부를 판단한다. | 정지 구간이 과도하게 길어지면 CPR 품질 저하. 정지 구간은 설정된 시간(예: 3-5초) 이내로 제한한다.
A02 | 심폐소생술(CPR) 수행 | A02_B01 | 압박 속도-깊이 유지 | 스카치 요크 기반 구동으로 분당 100-120회 압박 속도와 약 5cm 압박 깊이를 목표로 반복 압박을 수행한다. | 환자 흉곽 강성 차이에 따라 과압박 위험. 과부하 감지(전류-하중) 시 자동 감속-정지한다.
 |  | A02_B02 | 피드백 제어(PID-엔코더) | 엔코더 또는 리미트 스위치로 피스톤 위치를 추정하고, 목표 스트로크-주기를 유지하도록 PID 제어를 수행한다. | 센서 이상(단선-오프셋) 시 오작동 가능. 이중 안전장치(하드스탑-비상정지)와 연동한다.
 |  | A02_B03 | 30회 압박-정지 안내 | 가슴 압박 30회를 수행한 뒤 3-5초 일시 정지하며, LCD-음성으로 인공호흡 또는 다음 단계 안내를 제공한다. | 구조자가 인공호흡을 수행하지 못하는 상황에서는 압박 단독 모드로 전환 가능하도록 선택지를 제공한다.
 |  | A02_B04 | 비상정지-종료 | 구조자 비상정지 버튼 또는 전원 종료 입력 시 즉시 모터를 정지하고 초기 위치로 복귀(Homing)한다. | 복귀 중 기구 걸림 발생 시 추가 손상 우려. 복귀는 저속으로 수행하고 토크-전류 제한을 적용한다.
A03 | 지면 음압 고정 | A03_B01 | 음압 생성-고정력 확보 | BLDC 블로워로 챔버 내부 공기를 배기해 바닥과의 압력차(ΔP)로 하방 고정력을 생성한다. | 다공성 바닥(카펫) 또는 누설이 큰 조건에서 고정력 저하. 바닥 조건 경고 및 운용 제한을 제공한다.
 |  | A03_B02 | 진공도 모니터링-RPM 제어 | 압력 센서로 진공도를 실시간 모니터링하고, 목표 진공도 유지가 되도록 블로워 RPM을 보정한다. | 센서 오류로 과도한 RPM 상승 가능. 상한값-복구 실패 조건을 포함해 페일세이프를 구현한다.
 |  | A03_B03 | 고정 인터록 | 진공도가 임계값을 일정 시간 이상 만족하기 전에는 CPR 구동을 시작하지 않는 인터록을 적용한다. | 임계값 도달 지연 시 초기 대응 지연. 임계값-시간은 실험 기반으로 최적화하고 수동 모드 옵션을 둔다.
A04 | 사용자 인터페이스 | A04_B01 | LCD 안내-상태 표시 | LCD에 단계(부팅-진단-CPR-대기), 환자 상태 요약, 구조자 요청사항(센서 착용, 이격 등)을 표시한다. | 야외 강한 조도에서 가독성 저하. 고휘도 패널-큰 글자 모드를 지원한다.
 |  | A04_B02 | 배터리-시스템 상태 표시 | 배터리 잔량, 오류 코드, 통신 연결 상태를 표시하고, 위험 상태에서는 경고를 우선 표시한다. | 배터리 센싱 오차 가능. 보수적 임계값(안전 마진)으로 경고를 설정한다.
A05 | 의료진 통신(IoMT) | A05_B01 | Wi-Fi/AP 데이터 전송 | ESP32 기반 Wi-Fi 또는 AP Web Server로 실시간 데이터 전송 및 대시보드 표시를 지원한다. | 현장 네트워크 부재 시 전송 불가. 로컬 저장 후 LTE 또는 후속 동기화 기능을 제공한다.
 |  | A05_B02 | LTE 긴급 알림 | LTE로 위치-환자 상태를 전송하고, 필요 시 시설 관리자에게 AED 지참 요청을 자동 발송한다. | LTE 음영 지역에서는 지연 발생. Wi-Fi 우선, 실패 시 SMS 기반 백업 또는 로컬 경보로 전환한다.
 |  | A05_B03 | 양방향 통신(WebSocket) | WebSocket 기반으로 의료진과 구조자 간 양방향 메시지-영상(확장) 통신을 지원한다. | 대역폭 부족 시 영상 품질 저하. 텍스트-핵심 바이탈 우선 전송으로 QoS 정책을 적용한다.
A06 | 시스템 운영-안전 | A06_B01 | Self-check-초기화 | 전원 인가 후 전압-통신-센서-모터 드라이버를 점검하고, 이상이 없으면 System Ready를 표시한다. | Self-check 실패 시 오작동 위험. 에러 코드 표시 후 재시동-점검 안내를 제공한다.
 |  | A06_B02 | 오류 처리-재시동 안내 | 센서 미응답, 과전류, 고정 실패 등 오류 발생 시 모터 정지 후 안내(재시동-점검)를 제공한다. | 반복 오류 시 현장 대응 어려움. 오류 로그 저장 및 원격 진단 전송을 지원한다.
 |  | A06_B03 | 전원-하드웨어 제약 | 12V 리튬이온 충전식 배터리 기반으로 동작하며, 스텝다운으로 전압을 조절한다. | 배터리 과방전-과열 위험. BMS-온도 감시 및 출력 제한 로직을 포함한다.
 |  | A06_B04 | 물리적 요구사항 | 무게 5kg 이하, PA6-CF-알루미늄 혼합 프레임, 대량 생산 가능한 비용, 비상정지 버튼을 포함한다. | 재질-공정 변경 시 강성-내구성 영향. 구조해석 및 반복 하중 시험으로 검증한다.
A07 | 전원 및 전원 무결성 (Power Integrity) | A07_B01 | 전원 레일 및 레귤레이터 분리 | 디지털 제어 회로(ESP32, 센서, 통신)는 구동 부하(모터, 블로워, 코일)와 분리된 전원 레일을 사용해야 한다. ESP32 및 센서 전원은 독립된 3.3V 레귤레이터를 통해 공급되어야 하며, 고전력 구동 회로와 전원을 공유해서는 안 된다. | 같은 전압이라도 구동 부하와 제어 회로의 전원 레일은 구분한다. 이 방법은 저주파 노이즈도 예방한다.
 |  | A07_B02 | 디커플링 및 로컬 전원 안정화 | 모든 IC 전원 핀과 레귤레이터 출력에는 로컬 디커플링 커패시터(≥0.1µF)를 전원 핀으로부터 5mm 이내에 배치해야 한다. 레일 근처에는 1~5cm 이내 벌크 커패시터(10~100uf)를 배치한다. | 디커플링을 통해 고주파 전류를 보충하고 벌크를 통해 저주파 전류를 보충한다. 이를 통해 ESP32 동작 중 전원 전압 변동은 정격 전압의 ±5%(0.16V) 이내로 유지되고 모터·코일 스위칭 시에도 3.3V 레일은 리셋 임계 전압 이하로 강하되지 않아야 한다.
 |  | A07_B03 | ADC 전원 안정성 | 배터리 전압 측정 및 전류 센서 ADC 입력 회로는 노이즈가 분리된 전원 및 접지 기준을 사용해야 하며, 구동 부하 스위칭에 따른 전원 변동의 영향을 받지 않아야 한다. | 배터리 측정 회로의 GND를 모터 쪽 GND와 멀리 떨어뜨린다. RC 필터를 ESP32의 ADC 핀 바로 앞(5mm 이내)에 배치한다. 이후 칼만 필터를 적용해 남은 노이즈를 정리한다.
 |  | A07_B04 | 전기적 안정 | 역극성(배터리 반대) 혹은 과전압에 의한 사고를 예방하기 위해 역삽입 방지용 다이오드와 TVS 다이오드를 배치한다. | TVS 다이오드는 외부로 노출되는 UART, I2C, 센서 커넥터에 필수로 장착한다. 그리하여 IEC 61000-4-2 기준 ±8kV 접촉 방전을 견딜 수 있어야 한다.
A08 | 노이즈 및 EMI/EMC 대응 | A08_B01 | 전원 노이즈(고주파) 차단 | 디지털 제어 레일은 다른 레일로부터의 노이즈 유입을 방지하기 위해 페라이트 비드(600Ω @ 100MHz, 1A 이상, 100m옴 이하, 0603 or 0805)를 통해 분리되어야 한다. | 높은 임피던스는 고주파 노이즈를 효과적으로 억제하지만, 신호 감쇠의 위험이 있다. 낮은 임피던스는 신호 감쇠가 적지만, 노이즈 억제 효과가 제한될 수 있다. 구동부는 비드 사용시 열 발생이 심하다.
 |  | A08_B02 | 구동부 발생 노이즈 차단 | 플라이백 다이오드를 통해 고주파 노이즈 생성을 막는다.
 |  | A08_B03 | 신호 무결성(Signal Integrity) | 연속적인 GND(예: 4층 기판의 전체가 GND)가 필요하며 끊어야 할 시 고속 신호선 아래는 피한다. ESP32에서 배터리 측정부까지 가는 선은 최대한 짧게 만들고, 주변에 PWM이나 모터 제어선이 지나가지 못하게 한다. | PWM/모터 제어선은 ADC 입력선은 최소한 선 폭의 3배 이상 거리를 띄운다. 또한, 이 둘은 나란하게 배치하지 않는다.
A09 | 접지 및 리턴 경로 설계 | A09_B01 | 접지 분리 및 단일점 접지 | 고전력 구동 회로(GND_ACT)와 제어·센서 회로(GND_LOGIC)는 PCB 상에서 분리된 접지 영역을 사용하며, 단일 지점에서만 연결되어야 한다. 또한, 두 GND는 가능한 멀리 배치한다. 단일 접점(Star Ground)의 위치는 전원 입력 커넥터 바로 근처나 레귤레이터의 입력 커패시터 근처가 가장 이상적이다. | GND가 하나일 시 GND 자체 전류에 의한 전압 강하 혹은 상승이 일어나 esp32에 오류를 일으킨다. 구동부 GND는 짧고 굵게, 제어 GND는 노이즈원으로부터 멀게 설정한다.
 |  | A09_B02 | 고전류 경로 분리 | 모터, 블로워, 콘택터 코일의 전류 경로는 ESP32 및 ADC 전원·접지 경로를 통과해서는 안 된다. | 물리적 위치, 전기적 경로(전원), 접지 리턴(Return) 경로를 달리한다.
A10 | 신뢰성 및 보호 | A10_B01 | 전기적 안정 | 역극성(배터리 반대) 혹은 과전압에 의한 사고를 예방하기 위해 역삽입 방지용 다이오드와 TVS 다이오드를 배치한다. | TVS 다이오드는 외부로 노출되는 UART, I2C, 센서 커넥터에 필수로 장착한다. 그리하여 IEC 61000-4-2 기준 ±8kV 접촉 방전을 견딜 수 있어야 한다.
 |  | A10_B02 | 초기 GPIO 플로팅(Floating) 방지 | 중요한 제어 핀(모터 PWM, 코일 제어 등)에는 반드시 10kΩ~100kΩ 정도의 풀다운(GND로 연결) 저항을 달아야 한다. | 전기가 들어올 때 높은 전압부터 차례대로 안정화하고 이 사이에 모터가 작동하지 않고록 한다. Brown-out Detector(SW) 활성화를 통해 저전압 상태에 오작동을 예방한다.
A11 | 열 및 물리적 설계 | A11_B01 | 열 관리 | 전력 소자(레귤레이터, MOSFET)는 충분한 구리 면적 또는 열 비아를 통해 발열을 분산해야 한다. ESP32 주변에는 열원(모터 전원, MOSFET)을 배치하지 않아야 한다. | 레귤레이터 아래에 5~10개의 구멍을 뚫고 MOSFET 패드의 배선 폭을 넓게 한다.
 |  | A11_B02 | 기계적 신뢰성 | 외부 커넥터 및 고전류 단자는 기계적 응력에 견딜 수 있도록 PCB 가장자리에 배치되어야 한다.
A12 | 검증 및 디버깅 | A12_B01 | 테스트 포인트 | SMD 패드 형태로 제공하며, 전원(3.3V, 5V), GND, 주요 ADC 입력, PWM 출력 및 통신 신호에는 디버깅이 가능한 테스트 포인트를 배치해야 한다. 각 신호 테스트 포인트에는 인접한 GND 테스트 포인트를 함께 제공해야 한다. | TP_3V3, TP_GND, TP_PWM_MOTOR, TP_ADC_BATT 최소한 이 4개는 장착하는 것이 좋다. 다만, 공간 문제는 해결 해야할 부분이다.
A13 | 공통 PID 구조 | A13_B01 | 폐루프 제어 | PID 제어는 센서 피드백을 사용하는 폐루프 구조로 구현되어야 한다. CPR은 엔코더 기반 위치의 변화량, 음압 고정은 압력 센서 기반 파스칼 측정을 신호로 한다. | 바닥이나 사람의 가슴은 모두 고정되어 있는 존재가 아니다. 즉, 기계가 작동할 때마다 측정과 피드백이 필요하다.
 |  | A13_B02 | 이산 PID 구현 | 엔코더 값을 측정한 뒤 타이머 인터럽트 기반 주기 실행으로 PID 계산을 한 후 출력한다. 마찬가지로 압력 센서를 통해 ADC 샘플값을 측정 후 PID 계산을 통해 블로워 RPM 지령을 한다. | 연속 PID는 실제로 존재하지 않는 이론적 존재이며 MCU(본 시스템 ESP)는 타이머 인터럽트 기반이므로 이산 시간 형태로 구분한다.
 |  | A13_B03 | 고정 제어 주기 | PID 제어 루프는 고정된 주기로 실행되어야 한다. 제어 주기의 지터(Jitter)는 ±5% 이내로 제한되어야 한다. ADC 샘플링, PID 연산, PWM 출력은 동일한 제어 주기에 동기화되어야 한다. | 즉, 계속 같은 시간 간격으로 연산, 추출, 출력이 진행된다. 잘못 될 시, 과도한 적분 미분이 발생한다.
A14 | CPR 압박 메커니즘 PID | A14_B01 | 압박 깊이 제어 | 목표는 50mm로 하며 엔코더의 측정 각도를 압박 깊이로 환산한다. 또한, 허용 오차는 5mm로 정한다. 출력은 PWM duty로 한다. 주기는 2~5ms로 정한다.(일반적)
 |  | A14_B02 | 위치 기반 제어 | CPR 압박 제어는 시간 기준이 아닌 위치 기준으로 한다. 압박 제어 시작 전, 기준 위치(홈 포지션)를 설정해야 한다.(특수적) | 환자마다 가슴의 강성이 다르고 위치가 다르다. 시간 기반일 시 깊이에 도달하지 못한 상황을 도달한 상황으로 판단할 수 있다.
 |  | A14_B03 | 기계 포화 고려 | 구동계의 물리적, 전기적 한계를 고려한다. PWM 0~90% 혹은 구동계 전류 제한값을 고려한다. 만일, 기계가 포화 상태일 시 적분항 누적을 중단하고 제어적 정지를 통해 멈춘다. | 다만, 이는 구동계의 성능을 고려하여 구동계를 선택할 시 거의 일어나지 않는다. 비상 상황을 고려한 경우이다.
 |  | A14_B04 | Anti-windup 적용 | 제어 출력이 물리적 한계에 도달할 경우, 적분 항은 제한되거나 동결되어야 한다. Clamping + Soft Stop 연계를 통해 기계를 멈춘다. | clamping은 적분항을 없애지 않고 동결 시키는 것을 의미한다. 갑작스러운 멈춤일 시 환자의 가슴에 무리가 갈 수 있다.
 |  | A14_B05 | Bumpless 동작 | 제어 모드 전환 시, 제어 출력은 연속성을 유지해야 하며 압박력 또는 속도의 급격한 변화가 발생하지 않아야 한다. Integral State Preload(PID=현재출력)와 Setpoint Ramp(목표 깊이 변화 5mm->50mm)를 통해 구현한다. | Bumpless는 모드 전이 순간에만 동작한다. 이후, Anti-windup를 통해 정상 궤도에 진입한다.
 |  | A14_B06 | 비상 정지 연동 | 비상 정지 또는 오류 발생 시 PID 제어는 즉시 비활성화되어야 한다. Hard stop과 safe state 2단계를 통해 진행된다. | 과전류, 모터드라이버 Fault, 센서 신호 상실, 통신 Watchdog Timeout 등과 같은 상황에서 E-stop 2단계를 통해 즉시 정지한 후 원상태로 돌아간다.
A15 | 진공 고정 블로워 PID | A15_B01 | 압력 기반 제어 | 블로워 PID는 압력 센서 피드백을 기반으로 목표 진공도를 유지하도록 동작해야 한다. 목표는 ?로 하고 오차 범위는 ?로 한다. 제어 주기는 10~50 ms로 한다.
 |  | A15_B02 | 제어 인터록 | 시스템은 진공 고정, 자가진단, 전원 상태, 오류 상태, 전원 상태 및 비상 정지 조건을 만족하지 않을 경우 CPR 구동을 허용하지 않아야 한다. | 제어 인터록은 제어 알고리즘과 독립적으로 동작하며, 기본 상태는 구동 금지(Fail-Safe)로 정의된다.
 |  | A15_B03 | 출력 제한 | 블로워 PID 출력은 BLDC 블로워의 허용 RPM 범위를 초과하지 않아야 한다. | 출력 제한이 발생한 상태에서는 적분 항 누적을 방지하기 위한 Anti-Windup이 적용되어야 한다.
 |  | A15_B04 | 안정성 우선 제어 | 진공 PID는 빠른 응답보다 진공도 안정성을 우선으로 설계되어야 한다. 즉, 진공 PID는 CPR 압박 제어보다 낮은 제어 대역폭으로 동작해야 한다. 또한, 정상 동작 상태에서 진공도 변동은 목표값 대비 ±X% 이내로 유지되어야 한다. | 진공 PID는 미분항의 영향을 최소화하거나 사용하지 않아야 한다. 압력 센서에 노이즈 영향을 준다.
A16 | 센서 및 필터링 관련 PID | A16_B01 | 센서 유효성 검증 | PID 제어 입력으로 사용되는 모든 센서 데이터는 물리적 범위 및 갱신 주기 검증을 통과해야 한다. 이 검증은 범위 검증, 갱신 주기 검증, 변화율 검증을 통해 이루어진다. | 센서 유효성 검증에 실패한 경우, 해당 센서를 사용하는 PID 제어는 즉시 비활성화되어야 한다.
 |  | A16_B02 | 노이즈 대응 | 엔코더 및 압력 센서 신호는 노이즈로 인한 PID 불안정을 방지하기 위해 적절한 필터링 기법을 적용할 수 있어야 한다. 필터링은 PID 입력 이전 단계에 실행되며 지연율이 없어야 한다. | 각 센서 특성에 따라 서로 다른 필터를 적용할 수 있어야 한다. 가장 많이 쓰이는 조합은 1차 저역통과 필터, 이동 평균, 미분항 전용 필터, 칼만 필터이다.
A17 | 안전 및 Fail-safe 요구사항 | A17_B01 | 출력 기본 상태 | 안전 기본값 정의를 모터는 정지로 한다. PID 비활성 상태 감지 후 출력을 초기화한다. 초기화 된 출력값(0)을 유지한다. | 비상 시에는 강제 PID 비활성화 되며 출력값은 안전값(0)으로 유지된다.
 |  | A17_B02 | 오류 복구 | 오류 해제 후 PID 재활성화 시 출력은 점진적으로 증가해야 한다. PID Integral Reset후, Ramp-up(점진 증가)를 사용해 정상 PID 출력에 완만하게 다가간다.

Sheet: 작성가이드
항목 | 작성 가이드
요구사항ID | 상위 요구사항 그룹 ID (예: A01, A02). 동일 그룹은 셀 병합으로 묶는다.
요구사항명 | 상위 요구사항의 이름(예: 환자 상태 진단, CPR 수행).
기능ID | 상위ID_하위번호 형식 권장(예: A01_B01).
기능명 | 기능을 동사-목적어 형태로 간결히 작성.
세부사항 | 입력-처리-출력 관점으로 2-4문장으로 기술. 수치 목표(예: 100-120회-분, 5cm)는 명시.
예외사항 | 오작동 가능 조건, 환경 제약, 안전 인터록 등 예외/제약과 대응을 기록.
작성 규칙 | 기간 표기는 1-2주, 3-5초처럼 '-'를 사용한다. (물결표시 사용 금지)
