SangHyeon-Shin/SAVER/release/README.md

# release/

`report/render.sh`의 변환 산출물(`_build/`)이 여기 생긴다. 산출물은 추적하지 않는다
(`.gitignore`의 `release/_build/` 규칙). 제출용 최종 파일만 별도로 보관한다.
