SangHyeon-Shin/SAVER/sources/README.md

# sources/

원본 자료 보관 영역 (private 저장소 `SAVER-docs` 이관 대상, `SPLIT_PLAN.md` 참조).

- `original/` — 논문, 규격, 데이터시트 원본. 수정하지 않는다.
- `extracted/` — `tools/extract_sources.py`로 뽑은 검색용 텍스트. 원본이 바뀌면 재생성한다.
