SangHyeon-Shin/SAVER/docs/specs/README.md

# docs/specs

명세 **원본 보존 영역**. 수정·삭제 금지.

이 디렉터리의 파일은 **2026년 8월 3일**에 공개되었습니다(커밋 `807fb2c`).
공개 시점과 내용이 그대로 기록으로 남아야 하므로 파일을 삭제하거나
이력을 바꾸지 마십시오. 삭제해도 git 이력과 GitHub 캐시에는 남습니다.

확장자는 2026-09-08에 실제 형식에 맞게 교정되었습니다(`.pdf` → `.zip` 11건,
`.docx` → `.txt` 3건). `.zip` 파일은 페이지 이미지(`N.jpeg`)와 추출 텍스트
(`N.txt`)를 담은 스캔 문서 컨테이너입니다.

앞으로의 문서·보고서·실험 자료는 **private 저장소 `SAVER-docs`**에 둡니다.
이 저장소에는 코드와 이미 공개된 명세만 유지합니다.
