SangHyeon-Shin/SAVER/report/01_intro.qmd

# 서론

기존 자동 흉부압박장치는 환자 체형에 따른 압박점 오차와 진공 고정 실패로
압박 품질이 저하되는 문제가 있다 [@ref1]. 본 과제는 강성 매핑 기반 압박점
자동 탐색과 음압 지면 고정을 통해 이를 개선한다.
