SangHyeon-Shin/SAVER/report/04_conclusion.qmd

# 결론

강성 매핑 기반 압박점 탐색과 음압 지면 고정 설계의 확정값을 정리하고 검증
현황을 확인했다. T3·T4 완료 후 최종 수치를 갱신한다.
