SangHyeon-Shin/SAVER/report/index.qmd

# 요약 {.unnumbered}

강성 매핑 기반 압박점 자동 탐색과 음압 지면 고정을 적용한 심폐소생 보조장치
(SAVER)의 설계 및 검증 결과를 정리한다. 수치는 `docs/PROJECT_STATE.md`를
단일 출처로 한다.
