SangHyeon-Shin/SAVER/docs/document_index.md

# 프로젝트 문서 색인

**개발에 직접 필요한 15건만 이 저장소의 `docs/specs/` 에 있습니다.**
나머지 문서·원자료·보고서는 private 저장소 `SAVER-docs` 로 옮겼습니다(2026-09-08).
더 이상 팀 공유 드라이브를 뒤지지 않아도 됩니다.

---

## 1. 이 저장소에 있는 것 — `docs/specs/` 15건

**작업 전에 읽어야 하는 문서들입니다.**

확장자가 `.zip` 인 것은 스캔 문서 컨테이너입니다. 압축을 풀면 페이지 이미지
(`N.jpeg`)와 추출 텍스트(`N.txt`)가 나옵니다. 원래 `.pdf` 로 되어 있었으나
2026-09-08에 실제 형식에 맞게 교정했습니다. 자세한 내용은 `specs/README.md` 참조.

### 공통

| 파일 | 내용 | 누가 봐야 하나 |
|---|---|---|
| `S2_요구사항_정의서_자율응급처치시스템.xlsx` | 시스템 요구사항 전체 | 전원 |
| `S2_데이터_수집처리_정의서.zip` | 데이터 종류·주기·저장 형식. **기구 제어 100~500 Hz 근거** | 전원 |
| `S2_하드웨어_설계도.zip` | 전체 하드웨어 구성 | 전원 |

### Teensy (한건민)

| 파일 | 내용 |
|---|---|
| `W6_한건민_BOM_설계제안서_하드웨어센서_구성도.zip` | BOM, 센서 구성 |
| `W5_한건민_브레드보드_회로도.zip` | 브레드보드 배선 |
| `W11_한성윤_압박부_형상_설계서.zip` | 압박부 형상·치수 |

### Jetson · UI (신상현)

| 파일 | 내용 |
|---|---|
| `W7_신상현_Jetson_적용_범위_SW_요구사항.zip` | **Jetson 담당 범위, CSV 로그 포맷, 에러코드 `S-UU-EEE` 체계** |
| `W12_한성윤_UI_상태머신_연동표_v2.txt` | **S1~S13 화면·이벤트 정의. `protocol/state_machine_v2.json` 의 원본** |
| `W12_한성윤_상태머신_상태목록_v1__1_.txt` | 상태 목록 |
| `W9_한성윤_알고리즘_설계서.zip` | 5개 알고리즘 설계 |
| `w11_한성윤_사용자_실수_케이스_및_UI_경고_연결.zip` | 사용자 실수 → UI 경고 매핑 |

### 의학·안전 (한성윤)

| 파일 | 내용 |
|---|---|
| `W11_한성윤_상태_판단_로직_정의서_v1__의학_관점.zip` | 의학 관점 상태 판단 |
| `W12_한성윤_SAVER_근거추적표_v2.txt` | **설계 결정 ↔ 의학 근거 추적. 임계값 확정 시 여기 근거를 단다** |
| `W11_한성윤_마네킹_기반_시험_프로토콜_v1.zip` | 마네킹 시험 절차 |
| `W11_한성윤_CPR_시험_중_위험_상황_관찰_항목_정리.zip` | 시험 중 위험 관찰 항목 |

이 파일들은 2026-08-03 공개 시점의 기록이라 **삭제·이력 변경을 금지**합니다.

---

## 2. 나머지 — private 저장소 `SAVER-docs`

문서 92건과 추출 텍스트 91건이 아래 경로에 분류돼 있습니다.

| 경로 | 내용 |
|---|---|
| `sources/original/` | 선행연구·시장조사·기술동향·의학 리서치 |
| `sources/original/specs/` `specs2/` | 정의서·프로토콜·SW 요구사항 |
| `sources/extracted/` | **전 문서의 추출 텍스트. 검색은 여기서 `grep`** |
| `report/_archive/` | 중간보고서, 설계제안서, v4.2 종합해석, 최종보고서 |
| `cfd/` `mechanical/` `analysis/` | 구조해석 결과·그림, 캐드·배선, Simulink |
| `data/raw/interview/` `bench/` | 119 인터뷰, 센서·모터 작동확인 |
| `docs/admin/` | W1~W12 주간보고, 활동보고, 구매요청 |

**파일 단위 색인은 여기 두지 않습니다.** `SAVER-docs` 의 `docs/conversion_log.csv`
가 원본명 ↔ 파일명 ↔ 처리 내역의 단일 출처입니다. 목록을 두 곳에 적어 두면
어긋납니다 — 실제로 이 파일이 그렇게 어긋나 있었습니다.

> ⚠️ `SAVER-docs` 의 PDF 79건은 페이지 이미지에서 재조립한 것이라 텍스트
> 레이어도 벡터 도면도 없습니다. **보고서에서 "원본"으로 표기하지 마십시오.**
> 진짜 원본 확보 절차는 `SAVER-docs` 의 `docs/SOURCE_RECOVERY.md` 에 있습니다.

### 단계 접두어

| 접두어 | 기간 | 내용 |
|---|---|---|
| `S1_` | 2025년 2학기 | 공학설계입문 과제 (제안서, 최종발표) |
| `S2_` | 2025.12 ~ 2026.3 | 동계 집중 (대회 준비 시작) |
| `S3_`, `W12_` | 2026년 1학기 | 중간보고서, 인터뷰 |
| `W##_이름` | 주차별 | 개인 활동일지 |

---

## 3. 파일 이름 규칙

새 문서를 만들 때 지켜 주세요. 정렬과 검색이 쉬워집니다.

```
W07_신상현_젯슨_적용_범위.pdf      주차는 두 자리 (W7 아님)
S2_03_설계서.pdf                   단계_순번_주제
REF_ILCOR_2020_가이드라인.pdf      외부 참고자료는 REF_ 접두어
```

- 공백 대신 밑줄 `_`
- **마침표를 파일명 중간에 쓰지 않습니다.** iOS 에서 확장자가 잘립니다.
- 한글 파일명은 UTF-8. Windows 에서 깨지면 CP949/EUC-KR 로 재인코딩
- 이미 `SAVER-docs` 에 이관된 파일은 **이름을 바꾸지 마십시오.**
  `conversion_log.csv` 의 원본명 대응이 끊어집니다.

---

## 4. 문서를 코드로 옮길 때

**명세 문서의 값을 코드에 직접 하드코딩하지 마세요.**

의학적 임계값은 `AGENTS.md` 규칙에 따라 근거가 확인된 것만 씁니다.
값을 넣을 때는 `docs/specs/W12_한성윤_SAVER_근거추적표_v2.txt` 에 근거를 함께
등록하세요. 근거 없이 들어간 숫자는 최종보고서 심사에서 문제가 됩니다.

확정값은 `docs/PROJECT_STATE.md` §2 가 단일 출처입니다. 명세 문서와 어긋나면
`PROJECT_STATE.md` 가 우선하며, 제출 전 `tools/consistency_audit.py` 로 확인합니다.
