SangHyeon-Shin/SAVER/ui/src/assets/device.png

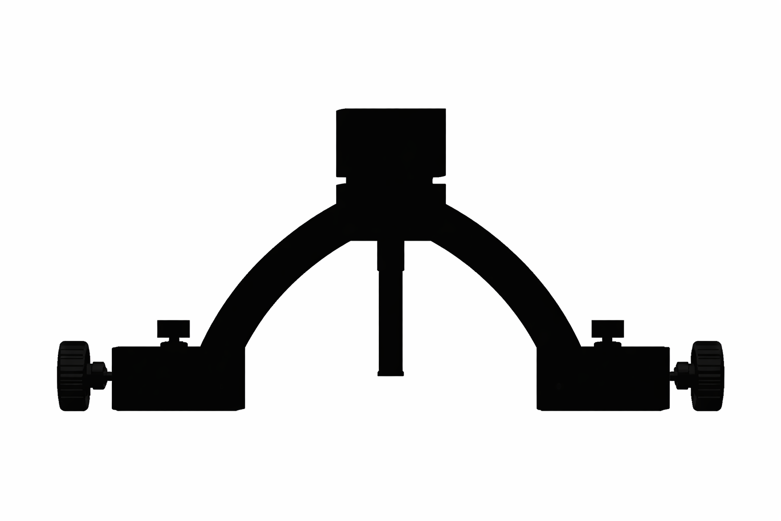
ui/src/assets/device.png
