SangHyeon-Shin/SAVER/ui/src/assets/ppg_sensor.png

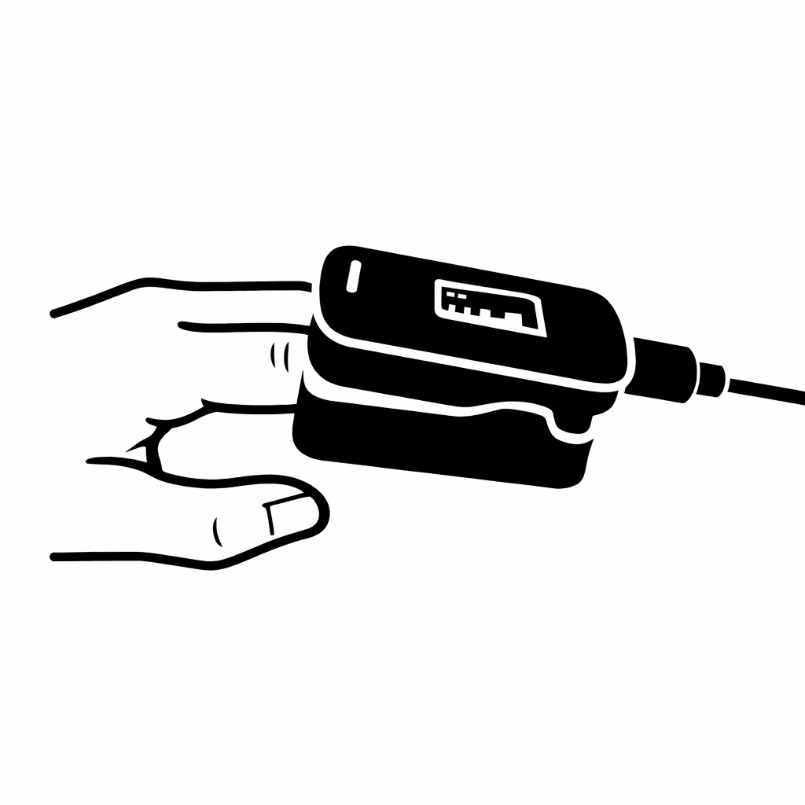
ui/src/assets/ppg_sensor.png
