SangHyeon-Shin/SAVER/docs/evidence.csv

claim_id | claim | source | level | verified_date | note
C1 | 진공 목표압력 -22.5 kPa 유지 가능 | firmware 소스 + T1 시험 | tested | 2026-09-07 | 장비 완비
C2 | 최대 압박력 555.1 N | W9 알고리즘 설계서 p.6 계산식 | simulated | 2026-09-07 | 실측 아님. 입력값은 문헌 가정. 하중셀 재선정 근거로만 사용
C3 | 진공 명목 유지력 3600 N (−20 kPa × 0.18 m²) | F=ΔP·A 계산 + CFD 운전점 | simulated | 2026-09-08 | 290 N(1:2 패드 추정값) 폐기. A_eff 확정 전 명목값. 실측은 T1
C4 | 강성 급감 지점 = 검상돌기 판정 절차 | W9_한성윤_알고리즘_설계서.pdf | assumed | 2026-09-07 | 문헌·설계 가정. 본 과제에서 임상 검증 안 함. 2026-08-03 공개됨
C5 | EAPD 산출식으로 목표 깊이 계산 | W11_한성윤_마네킹_기반_시험_프로토콜_v1.pdf | planned | 2026-09-07 | 마네킹 시험 결과 대기 (09-09 이후)
C6 | Jetson Nano 자동화 시험 40/40 통과 | jetson/ 실기 로그 | tested | 2026-09-07 | SW 단독 검증. 전체 시스템 통합시험 아님
C7 | 바닥 갭 0.05~0.30 mm 에서 운전 음압 −27.0~−17.6 kPa (보정 전 CFD) | cfd/SAVER_CFD_results_final.csv + BL6561-P 팬 커브(24 V 그림 판독) | simulated | 2026-09-08 | 격자 민감도 8/16/24셀 별도 제시. 1D 해 대비 갭 ≤0.10 mm 에서 −2.1~−0.7 %. 갭 0.30 mm 에서 관성 손실 최대 54 %
C8 | −30 kPa 는 BL6561-P(24 V) 로 도달 불가 (dead-head ≈27.3 kPa) | BL6561-P 팬 커브 | assumed | 2026-09-08 | 데이터시트 원문 확인 필요
