SangHyeon-Shin/SAVER/report/03_verification.qmd

# 검증

## 시험 현황

| 시험 | 상태 |
|---|---|
| T1 진공 고정 (−20 kPa) | 실시 가능 |
| T2 압박 심도·속도 제어 | 실시 가능 |
| T3 강성 매핑 | 하중셀·NAU7802 도착 조건부 |
| T4 구동부 휠/안전핀 | 10-24 연기 |

: 검증 시험 현황

소프트웨어는 Jetson Nano 실기에서 자동화 시험 40/40 통과를 확인했다(`tested`).
최대 압박력 555.1 N은 정역학 해석 결과이며(`simulated`) 실측치가 아니다.
