SangHyeon-Shin/SAVER/jetson/saver/protocol.py

#!/usr/bin/env python3
# -*- coding: utf-8 -*-
"""SAVER USB 프로토콜 v1.0 — Jetson 측 구현

명세: protocol/teensy_usb_protocol_v1.md
Teensy 측 대응 구현: teensy/saver_proto.h

Python 3.6 (JetPack 4.6.x) 호환. f-string·dataclass·walrus 사용하지 않습니다.
"""
import json

PROTO_VERSION = 1
MAX_LINE = 512

# ── 명령 (명세 §5) ───────────────────────────────────────────────
CMD = [
    "PING", "GET_STATUS", "ARM", "DISARM", "HOME", "SET_TARGET",
    "VACUUM_ON", "VACUUM_OFF", "STIFFNESS_SCAN", "SET_CP_POINT",
    "TRIAL_COMPRESSION", "START_CPR", "PAUSE_CPR", "RESUME_CPR",
    "STOP_CPR", "RESET_FAULT", "SET_TEL_RATE",
]

# ── Teensy 내부 상태 (명세 §7) — Jetson의 S1~S13과 별개 ──────────
MCU_STATES = [
    "IDLE", "ARMED", "HOMED", "VACUUM_HOLD", "CPR_READY",
    "CPR_RUNNING", "CPR_PAUSED", "FAULT", "ESTOP",
]

# ── 타이밍 (명세 §9) ─────────────────────────────────────────────
ACK_TIMEOUT_S = 0.2
ACK_RETRY = 2
HEARTBEAT_S = 1.0
STALE_S = 0.5       # 텔레메트리가 이보다 오래되면 표시값으로 쓰지 않는다
TEL_HZ_DEFAULT = 20

# ── 오류 코드 (명세 §8) ──────────────────────────────────────────
ERR = {
    "1-CM-003": "512 byte 초과 / 파싱 실패",
    "2-CM-002": "ACK 미수신",
    "3-CM-001": "프로토콜 버전 불일치",
    "3-CM-010": "통신 두절",
    "2-CU-011": "ARM 되지 않은 상태에서 구동 명령",
    "2-CU-012": "목표 깊이 도달 실패",
    "3-CU-021": "모터 과전류",
    "3-CU-022": "리미트 스위치 이탈",
    "3-CU-023": "엔코더 신호 상실",
    "2-VU-004": "음압 목표 미달",
    "2-VU-005": "음압 누설 감지",
    "3-VU-006": "흡착 상실",
    "1-PU-001": "PPG 신호 품질 저하",
    "2-PU-002": "PPG 센서 미착용/탈락",
    "2-VU-007": "음압 모터 드라이버 ERR 신호",
    "1-MU-010": "구동부 온도 상승 (팬 가동)",
    "2-MU-011": "구동부 온도 경고",
    "3-MU-001": "전원 전압 하한 미달",
    "3-MU-002": "비상정지 작동",
}


def severity(code):
    """'3-CU-021' → 3. 알 수 없으면 1(주의)로 처리한다."""
    try:
        return int(str(code).split("-")[0])
    except (ValueError, IndexError):
        return 1


ALARM_BY_SEV = {1: "caution", 2: "warning", 3: "danger"}


class ProtocolError(Exception):
    pass


def encode(msg):
    """dict → 한 줄 JSON(bytes). 명세 §3"""
    msg.setdefault("v", PROTO_VERSION)
    line = json.dumps(msg, ensure_ascii=True, separators=(",", ":"))
    if len(line) + 1 > MAX_LINE:
        raise ProtocolError("line too long: %d byte" % (len(line) + 1))
    return (line + "\n").encode("ascii")


def decode(line):
    """한 줄 → dict. 실패하면 None을 반환하고 호출부는 그 줄만 버린다.

    명세 §3: 파싱 실패로 프로그램이 죽으면 안 된다.
    """
    if isinstance(line, bytes):
        try:
            line = line.decode("utf-8", "replace")
        except Exception:
            return None
    line = line.strip()
    if not line or len(line) > MAX_LINE:
        return None
    try:
        msg = json.loads(line)
    except ValueError:
        return None
    if not isinstance(msg, dict) or "t" not in msg:
        return None
    return msg


def build_cmd(seq, cmd, **kw):
    msg = {"v": PROTO_VERSION, "t": "cmd", "seq": seq, "cmd": cmd}
    msg.update(kw)
    return msg


class SeqCounter(object):
    """1~65535 순환 (명세 §4.1)"""

    def __init__(self, start=1):
        self._n = start

    def next(self):
        n = self._n
        self._n = 1 if self._n >= 65535 else self._n + 1
        return n
