SangHyeon-Shin/SAVER/(commit log)

2026-01-22 PCB 회로도(멀메이드)
2026-02-18 음압 제어 및 펌웨어 코드
2026-02-18 esp32 통신 예제
2026-02-18 jetson 통신 예제(수신)
2026-08-03 저장소 구조 확립 · 프로토콜/상태머신 단일화 · 문서 정리
    구조
    - AGENTS.md: Codex(한건민)/Claude Code(신상현) 공통 규칙, 디렉터리 소유권
    - CLAUDE.md: @AGENTS.md 참조 한 줄 (규칙 이중화 방지)
    코드
    - protocol/: USB 통신 명세 v1.0a, 상태머신 S1~S13 단일 기준 JSON
    - jetson/: 브리지·상태머신·시리얼·로거 + 가짜 Teensy + 자동시험 40항목
    - teensy/: JSON 파서(외부 라이브러리 불필요) + 통신 골격 + 단위시험 26항목
    - ui/: 7인치 터치 UI 20화면. 브리지 연결 시 intent 방식, 미연결 시 로컬 전이
    문서
    - docs/PROJECT.md: 개요·팀·일정·환경·자주 막히는 곳
    - doc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
    [S2_요구사항_정의서_자율응급처치시스템.xlsx, state_machine_v2.json]
2026-08-05 [protocol] 안전 임계값 확정 및 실물 응답 검토
2026-08-05 [teensy] 핀맵 확정 및 센서 텔레메트리 취득
2026-09-07 [teensy] 외곽 핀 통합 배정 및 안전 초기화 반영
2026-09-07 [teensy] 음압 모터 및 압력센서 벤치 시험 추가
2026-09-07 [teensy] 음압 모터 단계별 시험 추가
2026-09-07 [teensy] 압력센서 미확정 환산 비활성화
2026-09-08 SAVER HQ 구조 도입 · 문서/근거 계층 · 특허 스캐너 설치
    - docs/: PROJECT_STATE.md(확정값 단일 출처), requirements.csv(15건),
    evidence.csv(6건), file-index.csv(79개 파일)
    - report/: Quarto 보고서 골격 + render.sh (quarto -> pandoc -> 파이썬 폴백)
    - tools/: patent_scan, consistency_audit, fix_extensions, extract_sources
    - report/analysis/cfd 에 디렉터리별 CLAUDE.md
    - AGENTS.md 에 문서·보고서 작업 규칙 append (기존 SW 규칙 보존)
    - .gitignore 보정: *.csv 전역 무시로 docs/*.csv 3종이 누락되던 문제 해결
    pre-commit 훅으로 patent_scan 설치. 훅이 requirements.csv 의 V3.0 미공개
    항목 명칭 유출을 실제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
    [evidence.csv, file-index.csv, requirements.csv]
2026-09-08 report: Quarto 실제 렌더링 통과 — 그림·양식·출력경로 결함 수정
    Quarto 1.10.18 로 실제 렌더링하여 아래 결함을 발견·수정했다.
    - 02_design.qmd 가 저장소에 없는 SVG 를 참조하여 그림이 누락되던 문제.
    figures/ 에 원본 SVG 와 변환 PNG 를 추가하고 PNG 를 참조하도록 변경.
    (docx 는 rsvg-convert 없이는 SVG 를 삽입하지 못한다)
    - _quarto.yml 이 존재하지 않는 templates/ksme-reference.docx 를 하드코딩
    참조하여 렌더링이 실패하던 문제. 설정에서 제거하고, 파일이 있을 때만
    render.sh 가 --metadata 로 적용하도록 변경.
    - output-dir 이 프로젝트 밖(../releas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
2026-09-08 report/CLAUDE.md: 그림 SVG->PNG 변환 절차 기록
2026-09-08 docs/specs: 확장자를 실제 파일 형식에 맞게 교정 (14건)
    tools/fix_extensions.py --apply 결과. 파일 내용은 변경하지 않았으며
    git 도 전부 순수 리네임(R)으로 인식한다.
    - .pdf 11건 -> .zip : 실제로는 스캔 이미지(JPEG)를 담은 ZIP 아카이브였다
    - .docx 3건 -> .txt : 실제로는 UTF-8 평문 텍스트였다
    기존 확장자로는 어떤 도구도 열지 못해 AI 작업·제출·아카이브 모두에서
    문제가 되던 상태를 해소한다. 2026-08-03 공개 시점의 파일 내용 자체는
    공지예외 주장 대상이므로 그대로 보존된다.
2026-09-08 extract_sources: 스캔 문서 컨테이너(.zip) 텍스트 추출 지원
    docs/specs 의 문서 11건은 확장자 교정 후 .zip 이며 내부에 페이지별
    *.txt 를 담고 있다. 기존 도구는 .zip 을 미지원으로 건너뛰어, 이 저장소의
    주된 사용처에서 아무것도 추출하지 못했다. 내부 *.txt 를 페이지 순서로
    이어 붙이도록 보완했다 (11건 전부 추출 확인).
    아울러 sources/extracted/ 를 추적 대상에서 제외한다. 원본이 이미 공개
    되었더라도 평문으로 풀어 두면 검색·색인이 가능해져 노출 수준이 달라진다.
    private SAVER-docs 에서는 이 규칙을 지우고 추적한다.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
2026-09-08 patent_scan: 설정 파일 읽기가 인코딩 때문에 죽던 문제 수정
    PowerShell 의 `>` 는 파일을 UTF-16LE 로 쓴다. SPLIT_PLAN 이 안내하는
    `echo "PRIVATE=1" > tools/patent_scan.cfg` 를 PowerShell 에서 실행하면
    UTF-16 파일이 만들어지고, UTF-8 로만 읽던 기존 코드가 UnicodeDecodeError
    로 죽어 pre-commit 훅 전체가 멈췄다. 실제로 SAVER-docs 에서 재현됨.
    BOM·UTF-16·cp949 를 순서대로 시도하고, 어느 것으로도 읽히지 않으면
    "private 아님"으로 간주해 검사를 계속한다. 설정 파일 하나 때문에 유출
    차단이 멈추는 쪽보다 안전한 기본값이다.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
2026-09-08 docs/specs: 원본 보존 안내 · report/render.sh: pandoc 폴백 그림·인용 누락 수정
    docs/specs/README.md
    이 디렉터리는 2026-08-03 공개분(807fb2c)이며 공개 시점과 내용이 기록으로
    남아야 하므로 삭제·이력 변경을 금지한다. 2026-09-08 확장자 교정 14건
    (.pdf -> .zip 11, .docx -> .txt 3)의 경위도 함께 남긴다.
    report/render.sh
    _merged.md 가 release/_build/ 에 생성되는데 그림 참조는 figures/
    상대경로라 해석이 깨져 그림이 조용히 누락됐다. --resource-path 로
    report/ 를 넘긴다. [@ref1] 인용도 --citeproc 없이는 처리되지 않아
    함께 추가했다. quarto 경로는 영향 없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
2026-09-08 README: 저장소 분리 반영 · 확정값 중복 서술 제거
    - 저장소 구성 절 추가. 문서·원자료는 private SAVER-docs 로 간다는 점과
    이 저장소의 analysis/ cfd/ data/ mechanical/ presentation/ sources/ 가
    구조만 남은 빈 디렉터리라는 점을 명시.
    - 구조 트리를 실제와 맞춤 (docs/PROJECT_STATE.md, report/, tools/, release/).
    - docs/specs 확장자 교정(.pdf -> .zip 11, .docx -> .txt 3)과 README 안내 추가.
    - "현재 상태"에서 확정값 표를 걷어내고 docs/PROJECT_STATE.md 를 단일 출처로
    가리키게 했다. README 가 음압 목표를 -30 kPa +-0.5 로, 과전류 임계를
    미확정으로 적고 있었으나 PROJ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
2026-09-08 patent_scan: 내용 문서를 검사 면제에서 제외 · 그 결과 드러난 노출 정리
    SELF_EXEMPT 에 PROJECT_STATE.md, document_index.md, DECISIONS.md,
    AGENTS.md, CLAUDE.md 가 들어 있어 이 파일들은 한 번도 검사되지 않았다.
    그 탓에 아래가 public 저장소에 올라간 채 훅에 걸리지 않았다.
    - PROJECT_STATE.md 의 지식재산 절차 일정과 담당 변리사 성명
    - document_index.md 의 명세 문서 목록
    면제는 스캐너 자신(patent_scan.py, .cfg)과 훅으로 줄였다. 문서가 키워드를
    정말 써야 하면 ALLOW_MARKER 를 파일 안에 남긴다 — AGENTS.md 가 이미 그렇게
    하고 있고, 그래야 왜 예외인지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
2026-09-08 [docs] 수치 기준 확정 — CFD 누설 해석·1:1 축척 반영 (D-23~D-28)
    - PROJECT_STATE §2: 축척 1:1, 블로워 BL6561-P(dead-head ≈27.3 kPa, 최소 연속
    유량 400 L/min), 요구 최소 음압 −6.2 kPa, 명목 유지력 3600 N(−20 kPa×0.18 m²),
    CFD 갭별 운전점 −27.0~−17.8 kPa, 구조 설계 하중 600 N 추가. "290 N" 폐기.
    §1 이번 주 일정, §3 미확정(힘 상한·A_eff·PETG·드라이버), §4 합격 기준 갱신.
    - DECISIONS: D-23 목표 음압 −22.5 근거(−30 도달 불가), D-24 290 N 폐기,
    D-25 축척 1:1, D-26 요구 음압 산정, D-27 간헐 운전(확인 조건부), D-28 합격 기준.
    D-31 음압 도달시간 항목 정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
    [evidence.csv, requirements.csv]
2026-09-08 [teensy] MAX30102 시험 추가 및 압력·음압 벤치 설정 정리
    MAX30102 단독 핀맵, I2C 취득, 접촉 상실 시 추정값 무효화와 자동 시험을 추가한다. 기존 메인/통합 시험의 잘못된 압력 환산을 비활성화하고 4.7k/10k 분압을 반영한다. 음압 단독 시험의 사용자 설정 6%, 15000ms를 보존한다.
    검증: Teensy 4.1 스케치 8개 컴파일 통과, 접촉 정책 컴파일 타임 검사 21개 및 원시 요약 로그 321개 재생 통과. 외부 SparkFun 라이브러리 경고 4종이 두 빌드에 발생했다. PC용 g++ 부재로 호스트 프로토콜 실행 시험은 미실행.
    업로드, 실물 시험, 푸시는 수행하지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
2026-09-08 [teensy] 음압 FG 제외 및 벤치 안전 정지 보완
2026-09-08 [docs] D-29 압박 프로파일 · D-30 벤치 시험 설정값 · 전원 6S · CFD 보정 전 운전점
    - DECISIONS: D-29(사인파 설계 기준·삼각파 제어 해석·555.1 N 보수적 상한),
    D-30(벤치 시험 깊이 50 mm·힘 상한 600 N, 임상값과 분리). 열린 문제 표에
    탐색 이송 방식·전압별 팬 커브·역류 방지 밸브·PCB 4S/6S·FEA E 가정 추가.
    - PROJECT_STATE §2: 프로파일·벤치 설정값·주전원 6S 행 추가, CFD 운전점을
    보정 전 값(−27.0~−17.6 kPa)으로, 요구 음압은 A_eff 확정 전 예비값 표기.
    §3 미확정 5건 추가, §4 T4 를 안전핀 모듈 시험(보고서 범위)으로 정의,
    §6 팬 커브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
    [evidence.csv, requirements.csv]
2026-09-09 음압 모터·압력 센서 통합 벤치 시험 추가
2026-09-10 [docs] D-24 정정(290 N = CFD 원형 모델 면적) · D-27 유지 논리 보완 · T1 24 V 한정
    - DECISIONS D-24: 290 N 은 CFD 축대칭 원형 패드 모델(r≈58 mm, 106 cm²) 면적 기준값.
    1:2 축척 추정 기록 정정. D-27: 목표 미도달 시 폴백 규칙, T1 정전압 24 V 한정.
    - PROJECT_STATE §2 CFD 운전점에 모델 형상 명시, §3 미확정 4건 추가(CFD 형상 재해석,
    압력 센서 실장 모델·변환식, 도달 시간 상한·블로워 연속 운전 시간, 힘 상한 치구),
    §4 T1 조건 갱신.
    - requirements R18 모델 형상 표기.
    consistency_audit 불일치 없음, patent_scan 차단 0건.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
    [requirements.csv]
2026-09-25 [docs] 공개 저장소에 둘 필요 없는 문구 정리, patent_scan 차단 목록 비공개화
    - tools/patent_scan.py: 차단 용어를 코드에서 빼고 저장소 밖 파일
    (tools/patent_scan_terms.txt, .gitignore 제외)에서 읽는다. 목록이 없으면
    경고 검사만 하고 커밋은 막지 않는다.
    - AGENTS.md: 차단 용어 예시를 목록 파일 안내로 교체.
    - docs/PROJECT_STATE.md, PROJECT.md, document_index.md, requirements.csv:
    지식재산 절차 일정·리스크 서술 삭제, 개인 일정 문구 일반화.
    - docs/README.md, ui/scripts/smoke-test.cjs: 개인 사정 표현 일반화.
    시험: ui build:single + smoke 18/18 통과, patent_scan --all 차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
    [requirements.csv]
2026-09-25 [ui] .gitignore 의 ui/src/generated/ 제외 규칙 복구 (같은 줄 주석으로 무효였음)
    Claude-Session: https://claude.ai/code/session_01QW4QC9QjzyNwxs5c5uqHwD
2026-10-01 teensy4.1 코드 수정 및 test 코드 업로드
    [bench_config.h, bench_guard.h, bench_logic.h, calibration_capture.h, compression_linear_pid_test.ino, compression_motor_single_test.ino, current_control.h, depth_control.h]
2026-10-04 [teensy] Serial8 및 Wire1 핀 이동 묶음 반영
2026-10-11 [teensy] 상태머신 v2.4 대조 기록과 바퀴 안내 정리
2026-10-23 [teensy] 수동 배치 시연 제어와 v1.1 통신 통합
